BerryAudio/BGP/GERBER/XMERGE/BGP_Combined_Bottom.png

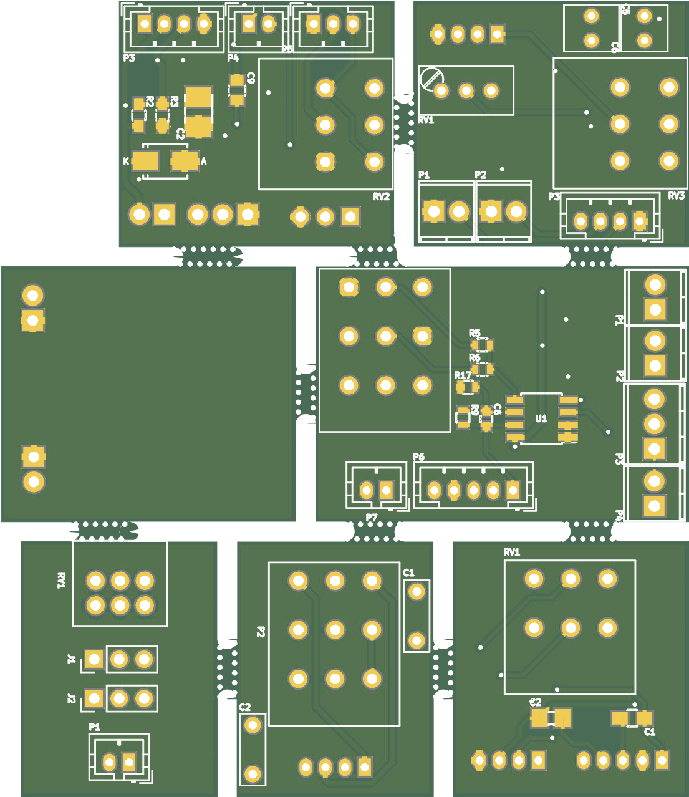
GERBER/XMERGE/BGP_Combined_Bottom.png
