BerryAudio/BGP/GERBER/XMERGE/BGP_Combined_Top.png

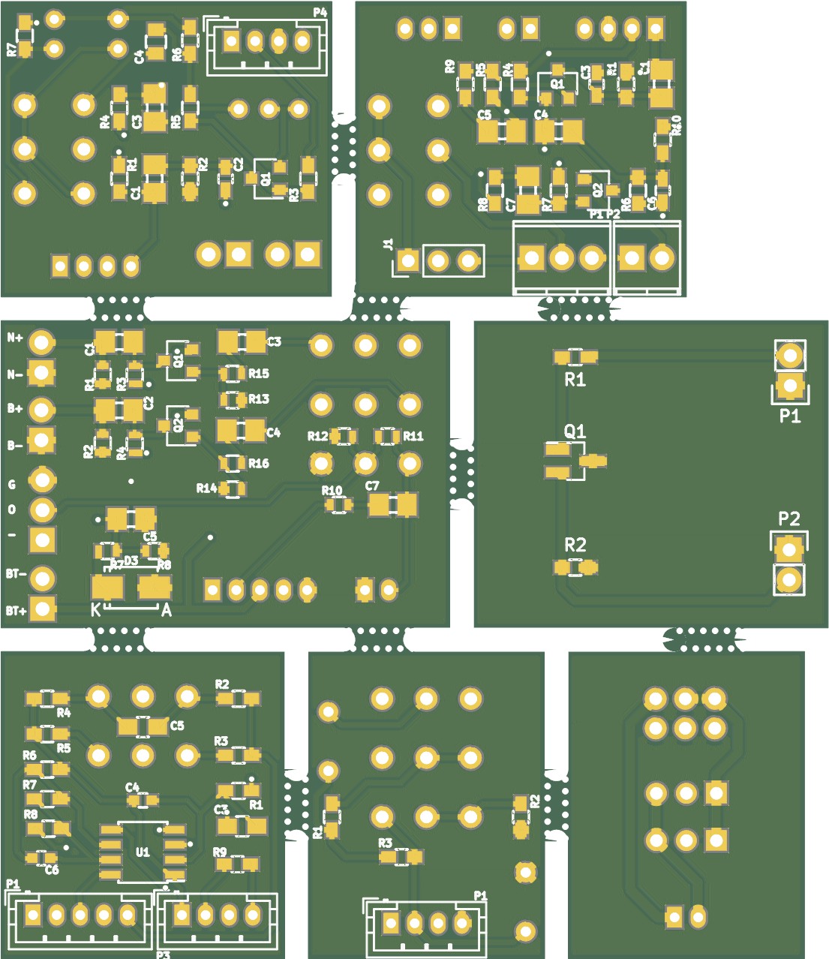
GERBER/XMERGE/BGP_Combined_Top.png
