BerryAudio/BGP/GERBER/BOM.xlsx

Sheet: J0
J0
VOL | QTY | VAL | PART NO
C | 3 | 0.1u | TAJR104K035RNJ | 35v | 0.627 | 1.881 | 11.286 | ECPU1C104MA5 | RS Australia
 | 3 | 47u | TCTAL1A476M8R | 10v | 0.657 | 1.971 | 7.884
 | 3 | 270p | CC0603JRNPO9BN271 | 50v | 0.048 | 0.144 | 0.96
 | 1 | 1u | F921A475MPA | 10v | 0.331 | 0.331 | 3.31
 | 1 | 1000p | ECH-U1H102JX5 | 50v | 0.431 | 0.431 | 4.31
D | 1 |  | S1A-13-F |  | 0.253 | 0.253 | 2.53
R | 2 | 1k | CR0603-FX-1001HLF |  | 0.019 | 0.038 | 1.9
 | 1 | 3.9k | CR0603-FX-3901ELF |  | 0.019 | 0.019 | 1.9
 | 3 | 10k | CR0603-FX-1002ELF |  | 0.019 | 0.057 | 1.9
 | 1 | 20k | CR0603-FX-2002ELF |  | 0.019 | 0.019 | 1.9
 | 1 | 100k | CR0603-FX-1003HLF |  | 0.019 | 0.019 | 1.9
 | 2 | 1MEG | CR0603-JW-105ELF |  | 0.009 | 0.018 | 0.9
 |  |  |  |  |  | 5.181 | 40.68
BT | QTY | VAL | PART NO
C | 1 | 2700p | 667-ECH-U1H272JX5 | 50v | 0.431 | 0.431 | 5.172
 | 1 | 0.1u | TAJR104K035RNJ | 35v | 0.627 | 0.627 | 7.524 | ECPU1C104MA5 | RS Australia
 | 1 | 47u | TCTAL1A476M8R | 10v | 0.657 | 0.657 | 7.884
 | 1 | 0.33u | MKS0C033300D00KSSD |  | 0.978 | 0.978 | 9.78
 | 1 | 1u | MKS02-1/50/10 |  | 1.89 | 1.89 | 18.9
R | 1 | 1.8k | CR0603-FX-1801ELF |  | 0.012 | 0.012 | 1.2
POT | 1 | 20k | 3296W-1-103LF |  | 2.55 | 2.55 | 25.5
 |  |  |  |  |  | 7.145 | 75.96
TERMINALS | QTY | VAL | PART NO
2WAY | 3 |  | 282834-2 |  | 0.616 | 1.848 | 11.088
3WAY | 1 |  | 282834-3 |  | 1.49 | 1.49 | 8.94
JACK | 1 |  | 502-12B |  | 4.69 | 4.69 | 9.38
SIL STRIP | 2 |  | D01-9972042 |  | 2.1 | 5.69 | 5.69
2PIN JUMPER | 2 |  | 571-1-881545-4 |  | 0.118 | 6.69 | 2.95
 |  |  |  |  |  | 20.408 | 38.048
 |  |  |  |  |  | 32.734 | 154.688

Sheet: F0
J0
BUF | QTY | VAL | PART NO
C | 1 | 270p | CC0603JRNPO9BN271 | 50v | 0.048 | 0.048 | 0.96
 | 2 | 0.1u | TAJR104K035RNJ | 35v | 0.627 | 1.254 | 7.524 | ECPU1C104MA5 | RS Australia
 | 2 | 1u | F921A475MPA | 10v | 0.331 | 0.662 | 3.31
 | 2 | 10u | TCTP1C106M8R | 16V | 0.663 | 1.326 | 6.63
D | 1 |  | S1A-13-F |  | 0.019 | 0.019 | 1.9
R | 3 | 1k | CR0603-FX-1001HLF |  | 0.019 | 0.057 | 1.9
 | 2 | 10k | CR0603-FX-1002ELF |  | 0.019 | 0.038 | 1.9
 | 1 | 12k | CR0603-FX-1202ELF |  | 0.019 | 0.019 | 1.9
 | 1 | 15k | CR0603-FX-1502HLF |  | 0.019 | 0.019 | 1.9
 | 2 | 20k | CR0603-FX-2002ELF |  | 0.019 | 0.038 | 1.9
 | 2 | 47k | CR0603-FX-4702ELF |  | 0.019 | 0.038 | 1.9
 | 2 | 100k | CR0603-FX-1003HLF |  | 0.019 | 0.038 | 1.9
 | 2 | 330k | CR0603-JW-334ELF |  | 0.009 | 0.018 | 0.9
 | 2 | 1Meg | CR0603-JW-105ELF |  | 0.009 | 0.018 | 0.9
Q | 1 | TS512A | TS512IDT |  | 1.27 | 1.27 | 12.7
BT | QTY | VAL | PART NO
C | 2 | 270p | CC0603JRNPO9BN271 | 50v | 0.048 | 0.096 | 0.96
 | 1 | 0.01u | ECH-U1C103JX5 | 16V | 0.45 | 0.45 | 4.5
 | 1 | 0.1u | TAJR104K035RNJ | 35v | 0.627 | 0.627 | 3.762
 | 2 | 10u | KRM21ER61E106KFA1L | 25V | 0.461 | 0.922 | 4.61
R | 1 | 1k | CR0603-FX-1001HLF |  | 0.019 | 0.019 | 1.9
 | 3 | 1.8k | CR0603-FX-1801ELF |  | 0.012 | 0.036 | 1.2
 | 2 | 6.8k | CR0603-FX-6801ELF |  | 0.012 | 0.024 | 1.2
 | 2 | 20k | CR0603-FX-2002ELF |  | 0.019 | 0.038 | 1.9
 | 1 | 100k | CR0603-FX-1003HLF |  | 0.019 | 0.019 | 1.9
Q | 1 | TS512A | TS512IDT |  | 1.27 | 1.27 | 0
MID | QTY | VAL | PART NO
C | 1 | 10n | MKS2C021001A00KI00 |  | 0.222 | 0.222 | 2.22
 | 1 | 22n | MKS2-.22/63/10 |  | 0.35 | 0.35 | 3.5
R | 2 | 4.7k | CR0603-FX-4701ELF |  | 0.019 | 0.038 | 1.9
 | 1 | 100k | CR0603-FX-1003HLF |  | 0.019 | 0.019 | 1.9
TERMINALS | QTY | VAL | PART NO
2WAY | 3 |  | 282834-2 |  | 0.616 | 1.848 | 11.088
3WAY | 1 |  | 282834-3 |  | 1.49 | 1.49 | 8.94
JACK | 1 |  | 502-12B |  | 4.69 | 4.69 | 9.38
SIL STRIP | 2 |  | D01-9972042 |  | 2.1 | 5.69 | 5.69
2PIN JUMPER | 1 |  | 571-1-881545-4 |  | 0.118 | 6.69 | 2.95

Sheet: MM
J0
SWITCHES | QTY | VAL | PART NO |  |  | $ | TOT
SW_SEL/MM | 2 |  | 100DP6T1B1M2QE |  | 4 | 5.71 | 22.84
SW_BRIGHT | 1 |  | 100SP1T1B1M2QEH |  | 2 | 2.83 | 5.66
SW_DUAL_MM | 1 |  | M2044SS1W03 |  | 1 | 21.2 | 21.2
BND
-
BT
C1 | 1 | 0.1u | TAJR104K035RNJ | 0805 | 2 | 0.627 | 1.254
C2, C13 | 2 | 1u | F921A475MPA | 0805 | 4 | 0.331 | 1.324
C3 | 1 | 10n | ECH-U1C103JX5 | 0805 | 2 | 0.791 | 1.582
C4 | 1 | 1.8n | ECH-U1H182JX5 | 0805 | 2 | 0.71 | 1.42
C5 | 1 | 10u | TCP1A106M8R | 0805 | 2 | 0.549 | 1.098
C6, C9 | 2 | 47u | TCTAL1A476M8R | 1206 | 4 | 0.657 | 2.628
C7 | 1 | 470p | VJ0603A471GXXCW1BC | 0603 | 2 | 0.134 | 0.268
C8, C12 | 2 | 120p | CC0603JRNPO9BN271 | 1206 | 4 | 0.048 | 0.192
C11 | 1 | 47n | ECH-U1C473GX5 | 1206 | 2 | 1.15 | 2.3
D | 1 |  | S1A-13-F |  | 2 | 0.253 | 0.506
Q1 | 1 |  | MMBF5457 |  | 2 |  | 0
R1 | 1 | 470k |  |  | 2 | 0.019 | 0.038
R2 | 1 | 1MEG |  |  | 2 | 0.019 | 0.038
R3, R9, R10, R12, R14 | 5 | 20k |  |  | 10 | 0.019 | 0.19
R4, R16 | 2 | 100 |  |  | 4 | 0.019 | 0.076
R5, R13 | 2 | 200k |  |  | 4 | 0.019 | 0.076
R6, R8 | 2 | 2k |  |  | 4 | 0.019 | 0.076
R7 | 1 | 100k |  |  | 2 | 0.019 | 0.038
R11 | 1 | 10k |  |  | 2 | 0.019 | 0.038
R15 | 1 | 1k |  |  | 2 | 0.019 | 0.038
U1 | 1 |  | TS512A |  | 2 | 1.27 | 2.54
RV1 | 1 | 1MEG | RV16AF-20-15S1-C1M-LA |  | 2 | 2.16 | 4.32
BASS
RV1 | 1 | 250k | RV16AF-20-15S1-A250K-LA |  | 2 | 2.16 | 4.32
2WAY | 3 |  | 282834-2 |  | 6 | 0.616 | 3.696
3WAY | 2 |  | 282834-3 |  | 4 | 1.49 | 5.96
 |  |  |  |  |  |  | 83.716

Sheet: Sheet1
C | 1 | VAL | TYPE | RATING | FOOTPRINT | PART | QTY 2 | QTY BEST | COST1 | COST10 | COST50 | TOTAL | SHEETS DONE
 | 1 | 10p | CERMAIC C0G | 25V | 0603 | VJ0603A100JXXCW1BC | 2 | 10 | 0.138 | 0.138 | 0.083 | 1.38 | F0 | BT
 | 2 | 68p | CERMAIC C0G | 25V | 0603 | VJ0603A680KXXPW1BC | 4 | 10 | 0.138 | 0.138 | 0.083 | 1.38 |  | BUF
 | 3 | 100p | CERMAIC C0G | 25V | 0603 | VJ0603A101KXXPW1BC | 6 | 10 | 0.138 | 0.138 | 0.083 | 1.38 |  | MID
 | 7 | 270p | CERMAIC C0G | 50V | 0603 | VJ0603A271JXACW1BC | 14 | 20 | 0.111 | 0.111 | 0.097 | 2.22 |  | TONE
 | 1 | 1n | FILM | 50V | 0805 | ECH-U1H102JX5 | 2 | 4 | 0.774 | 0.445 | 0.3 | 3.096 | J0 | BND
 | 4 | 2700p | FILM | 50V | 0805 | ECH-U1H272JX5 | 8 | 10 | 0.774 | 0.445 | 0.3 | 4.45 |  | BT
 | 1 | 4700p | FILM | 16V | 0805 | ECH-U1C472JX5 | 2 | 4 | 0.761 | 0.434 | 0.293 | 3.044 |  | VOL
 | 3 | 10n | FILM | 16V | 0805 | ECH-U1C103GX5 | 6 | 10 | 0.871 | 0.495 | 0.495 | 4.95 | MM | BT
 | 1 | 22n | FILM | 16V | 1206 | ECH-U1C223JX5 | 2 | 4 | 0.719 | 0.39 | 0.39 | 2.876 |  | MID
 | 1 | 22n | FILM | 40V | RADIAL | MKP2D022201B00JO00 | 2 | 4 | 0.263 | 0.234 | 0.198 | 1.052 |  | BASS
 | 6 | 0.1u | FILM | 16V | 0805 | FCA0805C104M-J2 | 12 | 15 | 0.94 | 0.697 | 0.697 | 10.455 |  | VOL
 | 1 | 0.22u | FILM | 40V | RADIAL | MKS2D032201C00KI00 | 2 | 2 | 0.304 | 0.297 | 0.297 | 0.608 |  | SW_BR
 | 1 | 0.47u | FILM | 40V | RADIAL | MKS0C033300D00KSSD | 2 | 2 | 1.01 | 0.934 | 0.857 | 2.02 |  | SW_MM
 | 1 | 1u | FILM | 40V | RADIAL | MKS02-1/50/10 | 2 | 2 | 2.24 | 1.88 | 1.49 | 4.48 |  | SW_SEL
 | 3 | 1u | TANTALUM | 20V | 0805 | TAJR105K020YNJ | 6 | 10 | 0.36 | 0.261 | 0.261 | 2.61
 | 6 | 10u | TANTALUM | 16V | 0805 | TCTP1C106M8R | 12 | 15 | 0.83 | 0.685 | 0.685 | 10.275
 | 5 | 10u | CERAMIC X5R | 25V | 1206 | TMK316ABJ106KD-T | 10 | 15 | 0.567 | 0.271 | 0.271 | 4.065
 | 3 | 47u | TANTALUM | 10V | 1206 | F931A476KAA | 6 | 10 | 0.816 | 0.678 | 0.437 | 6.78
D | 2 | 2 | S1A |  | SMA | 512-S1A | 4 | 0 | 0.416 | 0.281 | 0.118 | 0
TERM BLOCK
 | 11 | x2 |  |  |  | 282834-2 | 22 | 22 | 0.719 | 0.636 | 0.62 | 13.992
 | 3 | x3 |  |  |  | 282834-3 | 6 | 6 | 1.54 | 1.41 | 1.3 | 9.24
U | 1 |  | TL061 |  | SOIC | TL061CDT | 2 | 4 | 0.609 | 0.501 | 0.306 | 2.436
POT | 1 | A25k | 16mm |  |  | RV16AF-20-15S1-A25K-LA | 2 | 2 | 2.23 | 1.91 | 1.7 | 4.46
 | 1 | A100k | 16mm |  |  | RV16AF-20-15S1-A100K-LA | 2 | 2 | 2.23 | 1.91 | 1.7 | 4.46
 | 1 | A250k | 16mm |  |  | RV16AF-20-15S1-A250K-LA | 2 | 2 | 2.23 | 1.91 | 1.7 | 4.46
 | 1 | C1M | 16mm |  |  | RV16AF-20-15S1-C1M-LA | 2 | 2 | 2.23 | 1.91 | 1.7 | 4.46
 | 1 | 20k | TRIM |  |  | 3296W-1-203LF | 2 | 2 | 3.33 | 2.63 | 2.32 | 6.66
R | 2 | 100 |  |  | 0603 | CR0603-JW-101ELF | 4 | 20 | 0.138 | 0.022 | 0.01 | 0.44
 | 7 | 1k |  |  | 0603 | CR0603-JW-102ELF | 14 | 40 | 0.138 | 0.022 | 0.01 | 0.88
 | 4 | 1.8k |  |  | 0603 | CR0603-JW-182ELF | 8 | 20 | 0.138 | 0.022 | 0.01 | 0.44
 | 2 | 3.9k |  |  | 0603 | CR0603-JW-392ELF | 4 | 20 | 0.138 | 0.022 | 0.01 | 0.44
 | 1 | 4.7k |  |  | 0603 | CR0603-JW-472ELF | 2 | 20 | 0.138 | 0.022 | 0.01 | 0.44
 | 2 | 6.8k |  |  | 0603 | CR0603-FX-6801ELF | 4 | 20 | 0.138 | 0.077 | 0.032 | 1.54
 | 12 | 10k |  |  | 0603 | CR0603-FX-1002GLF | 24 | 40 | 0.138 | 0.029 | 0.012 | 1.16
 | 1 | 15k |  |  | 0603 | CR0603-FX-1502ELF | 2 | 20 | 0.138 | 0.014 | 0.008 | 0.28
 | 8 | 20k |  |  | 0603 | CR0603-FX-2002HLF | 16 | 40 | 0.138 | 0.039 | 0.021 | 1.56
 | 11 | 100k |  |  | 0603 | CR0603-FX-1003HLF | 22 | 40 | 0.138 | 0.035 | 0.019 | 1.4
W | 4 | 200k |  |  | 0603 | CR0603-FX-2003ELF | 8 | 20 | 0.138 | 0.032 | 0.014 | 0.64
 | 3 | 470k |  |  | 0603 | CR0603-FX-4703ELF | 6 | 20 | 0.138 | 0.029 | 0.012 | 0.58
 | 6 | 1MEG |  |  | 0603 | CR0603-JW-105GLF | 12 | 40 | 0.138 | 0.048 | 0.021 | 1.92
SW | 2 | DPDT | ON ON ON |  |  | 100DP6T1B1M2QE | 4 | 4 | 5.89 | 5.64 | 4.66 | 23.56
 |  |  |  |  |  |  |  |  |  |  |  | 152.569
NP MOUSER
POT | 1 |  | ALPHA CONCENTRIC | A100k |  |  | 2
 | 1 |  |  | B50k |  |  | 2
 | 2 |  |  | B20k, 2xC100k |  |  | 4
 | 1 |  |  | A25k |  |  | 2
 | 1 |  |  | A250k |  |  | 2
 | 1 |  | BOURNES 2G P/P | A500k |  | PDB183-GTR22-504A2 | 2
U | 3 |  | TS512A |  |  |  | 6
Q | 6 |  | MMBF5457 |  |  |  | 12
CNN | 4 | K | JST | x2 |  |  | 8
 | 4 | K | JST | x4 |  |  | 8
SW | 1 |  | M2044SS1W03 |  |  |  | 2
PINS | 20 | x5 | Male Long/short
 | 1 | x3 | Female Short/Short
