BerryAudio/BGP/BOM.xlsx

Sheet: Sheet1
J0_BT
C | C1 | 0.1u | TANT | 0805 | TAJR104M020RNJ | 0.796 | 0.601
 | C2 | 27p | CERAMIC | 0603 | ECH-U1C101JX5 | 0.686
 | C3 | 47u | TANT | 0805 | T58W9476M6R3C0150 | 0.713
 | C4 | 2.7n | FILM | 0603 | ECH-U1H272GX5 | 0.796 | 0.457
 | C5 | 1u | FILM | 2.5mm | 505-MKS02-1/50/10 | 1.93
 | C6 | 470n | FILM | 2.5mm | 505-MKS02.47/63/10 | 2.22
P | P1 |  |  | 2.54mm | 282834-2 | 0.713 | 0.631
 | P2 |  |  | 2.54mm | 282834-2 | 0.713 | 0.631
Q | Q1 |  |  | SOT23 | MMBFJ202 | 0.494 | 0.199
R | R1 | 1.5MEG |  | 0603 | CR0603-FX-1504ELF | 0.165 | 0.04
 | R2 | 1MEG |  | 0603 | CR0603-FX-1004ELF | 0.137 | 0.034
 | R3 | 6.8k |  | 0603 | CR0603-FX-6801ELF | 0.137 | 0.077
 | R4 | 3.9k |  | 0603 | CR0603-FX-3901ELF | 0.137 | 0.034
 | R5 | 100 |  | 0603 | CR0603-FX-1000ELF | 0.137 | 0.049
 | R6 | 10k |  | 0603 | CR0603-FX-1002ELF | 0.137 | 0.029
 | R7 | 1.8k |  | 0603 | CR0603-FX-1801ELF | 0.137 | 0.029
RV | RV1 | 20k |  | 3296W | 3296W-1-203LF | 3.31 | 2.61
J0_VOL
C | C1 | 0.1u | TANT | 0805 | TAJR104M020RNJ | 0.796 | 0.601
 | C2 | 100u | CERAMIC | 0805 | 12106D107MAT2A | 0.947
 | C3 | 270p | FILM | 0603 | ECH-U1C271JXG | 0.439 | 0.214
 | C4 | 0.1u | TANT | 0805 | TAJR104M020RNJ | 0.796 | 0.601
 | C5 | 47u | TANT | 0805 | T58W9476M6R3C0150 | 0.713
 | C6 | 270p | FILM | 0603 | ECH-U1C271JXG | 0.439 | 0.214
 | C7 | 10u | TANT | 0805 | F920G106MPA | 0.508 | 0.446
 | C8 | 0.047u | FILM | MKP2 | MKS2D024701A00JI00 | 0.563 | 0.501
 | C8* | 0.1u | FILM | MKP2 | MKS2D031001A00KA00 | 0.206 | 0.199
 | C9 | 1n | FILM | 0805 | ECH-U1H102JX5 | 0.768 | 0.442
D | D1 | S1A-13-F |  | SMA | S1A-13-F | 0.384 | 0.259
P | P1 |  |  | 2.54mm | 282834-3 | 1.52 | 1.4
 | P2 |  |  | 2.54mm | 282834-2 | 0.713 | 0.631
Q | Q1 |  |  | SOT23 | MMBFJ202 | 0.494 | 0.199
 | Q2 |  |  | SOT23 | MMBFJ202 | 0.494 | 0.199
R | R1 | 1MEG |  | 0603 | CR0603-FX-1004ELF | 0.137 | 0.034
 | R2 | 100k |  | 0603 | CR0603-FX-1003ELF | 0.165 | 0.04
 | R3 | 10k |  | 0603 | CR0603-FX-1002ELF | 0.137 | 0.029
 | R4 | 10k |  | 0603 | CR0603-FX-1002ELF | 0.137 | 0.029
 | R5 | 4.7k |  | 0603 | CR0603-FX-4701ELF | 0.137 | 0.012
 | R6 | 1MEG |  | 0603 | CR0603-FX-1004ELF | 0.137 | 0.034
 | R7 | 20k |  | 0603 | CR0603-FX-2002ELF | 0.137 | 0.029
 | R8 | 100 |  | 0603 | CR0603-FX-1000ELF | 0.137 | 0.049
 | R9 | 1.8k |  | 0603 | CR0603-FX-1801ELF | 0.137 | 0.029
 | R10 | 1.5MEG |  | 0603 | CR0603-FX-1504ELF | 0.165 | 0.04
J0_BLEND | RV1 |  |  |  | PDB183-GTR22-504A2 | 8.63
F0_BT
C | C1 | 10u | TANT | 0805 | F920G106MPA | 0.508 | 0.446
 | C2 | 10u | TANT | 0805 | F920G106MPA | 0.508 | 0.446
 | C3 | 10n | FILM | 0805 | ECH-U1C103GX5 | 0.864 | 0.491
 | C4 | 270p | FILM | 0603 | ECH-U1C271JXG | 0.439 | 0.214
 | C5 | 0.1u | FILM | 0805 | ECP-U1C104MA5 | 1.15 | 0.66
 | C6 | 270p | FILM | 0603 | ECH-U1C271JXG | 0.439 | 0.214
R | R1 | 1.8k |  | 0603 | CR0603-FX-1801ELF | 0.137 | 0.029
 | R2 | 4.7k |  | 0603 | CR0603-FX-4701ELF | 0.137 | 0.012
 | R3 | 10k |  | 0603 | CR0603-FX-1002ELF | 0.137 | 0.029
 | R4 | 4.7k |  | 0603 | CR0603-FX-4701ELF | 0.137 | 0.012
 | R5 | 1k |  | 0603 | CR0603-FX-1001ELF | 0.137 | 0.029
 | R6 | 20k |  | 0603 | CR0603-FX-2002ELF | 0.137 | 0.029
 | R7 | 20k |  | 0603 | CR0603-FX-2002ELF | 0.137 | 0.029
 | R8 | 100 |  | 0603 | CR0603-FX-1000ELF | 0.137 | 0.049
U | U1 | TS512IDT |  |  | TS512IDT | 1.51 | 1.31
F0_BUF
C | C1 | 0.1u | FILM | 0805 | ECP-U1C104MA5 | 1.15 | 0.66
 | C2 | 0.1u | FILM | 0805 | ECP-U1C104MA5 | 1.15 | 0.66
 | C3 | 1u | TANT | 0805 | TPSR105K020R6000 | 0.37
 | C4 | 1u | TANT | 0805 | TPSR105K020R6000
 | C5 | 10u | TANT | 0805 | F920G106MPA | 0.508 | 0.446
 | C6 | 270p | FILM | 0603 | ECH-U1C271JXG | 0.439 | 0.214
D | D1 | S1A-13-F |  | SMA | S1A-13-F | 0.384 | 0.259
P | P1 |  |  | 2.54mm | 282834-3 | 1.52 | 1.4
 | P2 |  |  | 2.54mm | 282834-2 | 0.713 | 0.631
 | P2 |  |  | 2.54mm | 282834-2 | 0.713 | 0.631
 | P2 |  |  | 2.54mm | 282834-2 | 0.713 | 0.631
Q | Q1 |  |  | SOT23 | MMBF5457 | 0.494 | 0.199
 | Q2 |  |  | SOT23 | MMBF5457 | 0.494 | 0.199
R | R1 | 330k |  | 0603 | CR0603-FX-3303ELF | 0.137 | 0.034
 | R2 | 330k |  | 0603 | CR0603-FX-3303ELF | 0.137 | 0.034
 | R3 | 1MEG |  | 0603 | CR0603-FX-1004ELF | 0.137 | 0.034
 | R4 | 1MEG |  | 0603 | CR0603-FX-1004ELF | 0.137 | 0.034
 | R5 | 47k |  | 0603 | CR0603-FX-4701ELF | 0.137 | 0.036
 | R6 | 47k |  | 0603 | CR0603-FX-4701ELF | 0.137 | 0.036
 | R7 | 100k |  | 0603 | CR0602-FX-1003ELF | 0.137 | 0.034
 | R8 | 100k |  | 0603 | CR0602-FX-1003ELF | 0.137 | 0.034
 | R9 | 15k |  | 0603 | CR0603-FX-1502ELF | 0.137 | 0.049
 | R10 | 100 |  | 0603 | CR0603-FX-1000ELF | 0.137 | 0.049
 | R11 | 10k |  | 0603 | CR0603-FX-1002ELF | 0.137 | 0.029
 | R12 | 12k |  | 0603 | CR0603-FX-1202ELF | 0.137 | 0.029
 | R13 | 20k |  | 0603 | CR0603-FX-2002ELF | 0.137 | 0.029
 | R14 | 20k |  | 0603 | CR0603-FX-2002ELF | 0.137 | 0.029
 | R15 | 1k |  | 0603 | CR0603-FX-1001ELF | 0.137 | 0.029
 | R16 | 1k |  | 0603 | CR0603-FX-1001ELF | 0.137 | 0.029
 | R17 | 10k |  | 0603 | CR0603-FX-1002ELF | 0.137 | 0.029
U | U1 | TS512IDT |  |  | TS512IDT | 1.51 | 1.31
F0_MID
C | C1 | 22n | FILM | 5mm | MKS2D022201A00KO00 | 0.864 | 0.491
 | C2 | 10n | FILM | 5mm | MKS2C021001A00MI00 | 0.823 | 0.472
R | R1 | 4.7k |  | 0603 | CR0603-FX-4701ELF | 0.137 | 0.012
 | R2 | 4.7k |  | 0603 | CR0603-FX-4701ELF | 0.137 | 0.012
 | R3 | 100k |  | 0603 | CR0602-FX-1003ELF | 0.137 | 0.034
TONE CAPS | C1 | 47n |  | 5mm | 505-MKS2D024701AJI00 |  | 0.501
 | C2 | 470n |  | 5mm | MKS2C034701C00JO00 | 0.335
TERM BLK |  |  |  |  | 571-282834-2 | 0.631
 |  |  |  |  | 571-2828343 | 1.52

Sheet: Sheet2
 | C8 | 0.047u | FILM | MKP2 | MKS2D024701A00JI00 | 0.563 | 0.501
C | C1 | 0.1u | TANT | 0805 | TAJR104M020RNJ | 0.796 | 0.601
C | C1 | 0.1u | TANT | 0805 | TAJR104M020RNJ | 0.796 | 0.601
 | C4 | 0.1u | TANT | 0805 | TAJR104M020RNJ | 0.796 | 0.601
 | C8* | 0.1u | FILM | MKP2 | MKS2D031001A00KA00 | 0.206 | 0.199
 | C5 | 0.1u | FILM | 0805 | ECP-U1C104MA5 | 1.15 | 0.66
C | C1 | 0.1u | FILM | 0805 | ECP-U1C104MA5 | 1.15 | 0.66
 | C2 | 0.1u | FILM | 0805 | ECP-U1C104MA5 | 1.15 | 0.66
 | C2 | 100u | CERAMIC | 0805 | 12106D107MAT2A | 0.947
 | C3 | 10n | FILM | 0805 | ECH-U1C103GX5 | 0.864 | 0.491
 | C2 | 10n | FILM | 5mm | MKS2C021001A00MI00 | 0.823 | 0.472
 | C7 | 10u | TANT | 0805 | F920G106MPA | 0.508 | 0.446
C | C1 | 10u | TANT | 0805 | F920G106MPA | 0.508 | 0.446
 | C2 | 10u | TANT | 0805 | F920G106MPA | 0.508 | 0.446
 | C5 | 10u | TANT | 0805 | F920G106MPA | 0.508 | 0.446
 | C9 | 1n | FILM | 0805 | ECH-U1H102JX5 | 0.768 | 0.442
 | C5 | 1u | FILM | 2.5mm | 505-MKS02-1/50/10 | 1.93
 | C3 | 1u | TANT | 0805 | TPSR105K020R6000 | 0.37
 | C4 | 1u | TANT | 0805 | TPSR105K020R6000
 | C4 | 2.7n | FILM | 0603 | ECH-U1H272GX5 | 0.796 | 0.457
C | C1 | 22n | FILM | 5mm | MKS2D022201A00KO00 | 0.864 | 0.491
 | C3 | 270p | FILM | 0603 | ECH-U1C271JXG | 0.439 | 0.214
 | C6 | 270p | FILM | 0603 | ECH-U1C271JXG | 0.439 | 0.214
 | C4 | 270p | FILM | 0603 | ECH-U1C271JXG | 0.439 | 0.214
 | C6 | 270p | FILM | 0603 | ECH-U1C271JXG | 0.439 | 0.214
 | C6 | 270p | FILM | 0603 | ECH-U1C271JXG | 0.439 | 0.214
 | C2 | 27p | CERAMIC | 0603 | ECH-U1C101JX5 | 0.686
 | C6 | 470n | FILM | 2.5mm | 505-MKS02.47/63/10 | 2.22
 | C2 | 470n |  | 5mm | MKS2C034701C00JO00 | 0.335
TONE CAPS | C1 | 47n |  | 5mm | 505-MKS2D024701AJI00 |  | 0.501
 | C3 | 47u | TANT | 0805 | T58W9476M6R3C0150 | 0.713
 | C5 | 47u | TANT | 0805 | T58W9476M6R3C0150 | 0.713
TERM BLK |  |  |  |  | 571-282834-2 | 0.631
 |  |  |  |  | 571-2828343 | 1.52
Q |  | MMBFJ202 |  |  |  | 0.51 | 0.203
U | U1 | TS512IDT |  |  | TS512IDT | 1.51 | 1.31
 | R10 | 100 |  | 0603 | CR0603-FX-1000ELF | 0.137 | 0.049
 | R8 | 100 |  | 0603 | CR0603-FX-1000ELF | 0.137 | 0.049
 | R5 | 100 |  | 0603 | CR0603-FX-1000ELF | 0.137 | 0.049
 | R10 | 1.5MEG |  | 0603 | CR0603-FX-1504ELF | 0.165 | 0.04
R | R1 | 1.5MEG |  | 0603 | CR0603-FX-1504ELF | 0.165 | 0.04
R | R1 | 1.8k |  | 0603 | CR0603-FX-1801ELF | 0.137 | 0.029
 | R9 | 1.8k |  | 0603 | CR0603-FX-1801ELF | 0.137 | 0.029
 | R7 | 1.8k |  | 0603 | CR0603-FX-1801ELF | 0.137 | 0.029
 | R3 | 100k |  | 0603 | CR0602-FX-1003ELF | 0.137 | 0.034
 | R7 | 100k |  | 0603 | CR0602-FX-1003ELF | 0.137 | 0.034
 | R8 | 100k |  | 0603 | CR0602-FX-1003ELF | 0.137 | 0.034
 | R2 | 100k |  | 0603 | CR0603-FX-1003ELF | 0.165 | 0.04
 | R11 | 10k |  | 0603 | CR0603-FX-1002ELF | 0.137 | 0.029
 | R17 | 10k |  | 0603 | CR0603-FX-1002ELF | 0.137 | 0.029
 | R3 | 10k |  | 0603 | CR0603-FX-1002ELF | 0.137 | 0.029
 | R3 | 10k |  | 0603 | CR0603-FX-1002ELF | 0.137 | 0.029
 | R4 | 10k |  | 0603 | CR0603-FX-1002ELF | 0.137 | 0.029
 | R6 | 10k |  | 0603 | CR0603-FX-1002ELF | 0.137 | 0.029
 | R12 | 12k |  | 0603 | CR0603-FX-1202ELF | 0.137 | 0.029
 | R9 | 15k |  | 0603 | CR0603-FX-1502ELF | 0.137 | 0.049
 | R15 | 1k |  | 0603 | CR0603-FX-1001ELF | 0.137 | 0.029
 | R16 | 1k |  | 0603 | CR0603-FX-1001ELF | 0.137 | 0.029
 | R5 | 1k |  | 0603 | CR0603-FX-1001ELF | 0.137 | 0.029
 | R3 | 1MEG |  | 0603 | CR0603-FX-1004ELF | 0.137 | 0.034
 | R4 | 1MEG |  | 0603 | CR0603-FX-1004ELF | 0.137 | 0.034
R | R1 | 1MEG |  | 0603 | CR0603-FX-1004ELF | 0.137 | 0.034
 | R6 | 1MEG |  | 0603 | CR0603-FX-1004ELF | 0.137 | 0.034
 | R2 | 1MEG |  | 0603 | CR0603-FX-1004ELF | 0.137 | 0.034
 | R13 | 20k |  | 0603 | CR0603-FX-2002ELF | 0.137 | 0.029
 | R14 | 20k |  | 0603 | CR0603-FX-2002ELF | 0.137 | 0.029
 | R6 | 20k |  | 0603 | CR0603-FX-2002ELF | 0.137 | 0.029
 | R7 | 20k |  | 0603 | CR0603-FX-2002ELF | 0.137 | 0.029
 | R7 | 20k |  | 0603 | CR0603-FX-2002ELF | 0.137 | 0.029
 | R4 | 3.9k |  | 0603 | CR0603-FX-3901ELF | 0.137 | 0.034
R | R1 | 330k |  | 0603 | CR0603-FX-3303ELF | 0.137 | 0.034
 | R2 | 330k |  | 0603 | CR0603-FX-3303ELF | 0.137 | 0.034
R | R1 | 4.7k |  | 0603 | CR0603-FX-4701ELF | 0.137 | 0.012
 | R2 | 4.7k |  | 0603 | CR0603-FX-4701ELF | 0.137 | 0.012
 | R2 | 4.7k |  | 0603 | CR0603-FX-4701ELF | 0.137 | 0.012
 | R4 | 4.7k |  | 0603 | CR0603-FX-4701ELF | 0.137 | 0.012
 | R5 | 4.7k |  | 0603 | CR0603-FX-4701ELF | 0.137 | 0.012
 | R5 | 47k |  | 0603 | CR0603-FX-4701ELF | 0.137 | 0.036
 | R6 | 47k |  | 0603 | CR0603-FX-4701ELF | 0.137 | 0.036
 | R3 | 6.8k |  | 0603 | CR0603-FX-6801ELF | 0.137 | 0.077
RV | RV1 | 20k |  | 3296W | 3296W-1-203LF | 3.31 | 2.61
J0_BLEND | RV1 |  |  |  | PDB183-GTR22-504A2 | 8.63
RVTONE |  |  |  |  | RK09712200MT | 3.97

Sheet: Sheet3
PRJ | BOARD | POT | KNOB
J0 | VOL/TONE | 250kA/250kA | CONCENTRIC
 | BASS/TREBLE | 25kA/25kA | CONCENTRIC
 | BALANCE | MOUSER | SINGLE
F0 | VOL/BAL | 20kB/100kA | CONCENTRIC
 | BASS/TREBLE | 50kB/50kB | CONCENTRIC
 | MID | 20kB/100kA | CONCENTRIC
 | TONE | 20kA | SINGLE
 | Pot | Qty | Stock | Knob |  |  | SAD | NORM | STOCK | ORDER | LESS PHIL
 | 20kB/100kA | 4 | 2 | CONCENTRIC | 10 | 2 | 2 | 8 | 2 | 6 | 3
 | 50kB/50kB | 2 | 2 | SINGLE | 4 | 2 | 1 | 3 | 2 | 1 | 0
 | 250kA/250kA | 2 | 0
 | 25kA/25kA | 2 | 0
 | 20kA | 2 | 0
