BerryAudio/BGP/BGP_F1/BOM.xlsx

Sheet: Sheet1
BUF
R | R1 | 499k |  |  |  |  |  | 0603
 | R2 | 2.49k |  |  |  |  |  | 0603
 | R3 | 499k |  |  |  |  |  | 0603
 | R4 | 4.99k |  |  |  |  |  | 0603
 | R5 | 4.99k |  |  |  |  |  | 0603
 | R6 | 15k |  |  |  |  |  | 0603
 | R7 | 15k |  |  |  |  |  | 0603
 | R8 | 20k |  |  |  |  |  | 0603
 | R9 | 20k |  |  |  |  |  | 0603
 | R10 | 15k |  |  |  |  |  | 0603
 | R11 | 15k |  |  |  |  |  | 0603
POT | RV1 | 3296X |  | Bourns | 3296X-1-103LF | 3.31
C | C1 | 0.1u | TANTALUM | Vishay | TMCP1D104MTRF | 0.851 |  | 0805
 | C2 | 0.01u | FILM | Kemet | LDBCA1330GC5N0 | 1.34 | 0.849 | 1206
 | C3 | 0.01u | FILM | Kemet | LDBCA1330GC5N0 | 1.34 | 0.849 | 1206
 | C4 | 10u | TANTALUM | ROHM | TCTP1C106M8R | 0.823 | 0.679 | 0805
 | C5 | 10u | TANTALUM | ROHM | TCTP1C106M8R | 0.823 | 0.679 | 0805
IC | U1 | MC33178 | MSSOP | ON Semi |  | 1.13 | 0.955
HPF
R | R1 | 4.99k |  |  |  |  |  | 0805
 | R2 | 2.49k |  |  |  |  |  | 0805
 | R3 | 499k |  |  |  |  |  | 0805
 | R4 | 4.99k |  |  |  |  |  | 0805
 | R5 | 4.99k |  |  |  |  |  | 0805
 | R6 | 15k |  |  |  |  |  | 0805
 | R7 | 15k |  |  |  |  |  | 0805
C | C1 | 2.7n | FILM | CORNELL-Dubilier | FCP0805H272J-J1 | 0.755 | 0.546 | 0805
 | C2 | 100p | CERAMIC | AVX | 0805YA101JAT2A | 0.37 | 0.248 | 0805
 | C3 | 39n | FILM | Panasonic | ECH-U1C393GX5 | 1.18 | 0.671 | 1206
 | C4 | 10u | TANTALUM | ROHM | TCTP1C106M8R | 0.823 | 0.679 | 0805
 | C5 | 22u | TANTALUM | Vishay | TMCMA1C226MTRF | 0.37 |  | 1206
IC | U1 | MC33178 | MSSOP | ON Semi |  | 1.13 | 0.955
VOL
R | R1 | 249k |  |  |  |  |  | 0805
 | R2 | 249k |  |  |  |  |  | 0805
 | R3 | 4.99k |  |  |  |  |  | 0805
 | R4 | 4.99k |  |  |  |  |  | 0805
 | R5 | 4.99k |  |  |  |  |  | 0805
 | R6 | 4.99k |  |  |  |  |  | 0805
 | R7 | 4.99k |  |  |  |  |  | 0805
 | R8 | 4.99k |  |  |  |  |  | 0805
 | R9 | 100 |  |  |  |  |  | 0805
 | R10 | 10k |  |  |  |  |  | 0805
 | R11 | 12k |  |  |  |  |  | 0805
 | R12 | 100k |  |  |  |  |  | 0805
 | R13 | 100k |  |  |  |  |  | 0805
C | C1 | 1n | FILM | Panasonic | ECH-U1H102GX5 | 0.796 | 0.451 | 0805
 | C2 | 22u | TANTALUM | Vishay | TMCMA1C226MTRF | 0.37 |  | 1206
 | C3 | 22u | TANTALUM | Vishay | TMCMA1C226MTRF | 0.37 |  | 1206
D | D1 |  |  | Vishay | RGF1B-E3/67A | 0.659 | 0.497
IC | U1 | MC33178 | MSSOP | ON Semi |  | 1.13 | 0.955
 | U2 | MC33178 | MSSOP | ON Semi |  | 1.13 | 0.955

Sheet: Sheet2
3.978873577e-10
16931.37692
