BerryAudio/BGP/Datasheets/bartolini-switch-wiring-dual-coil.pdf

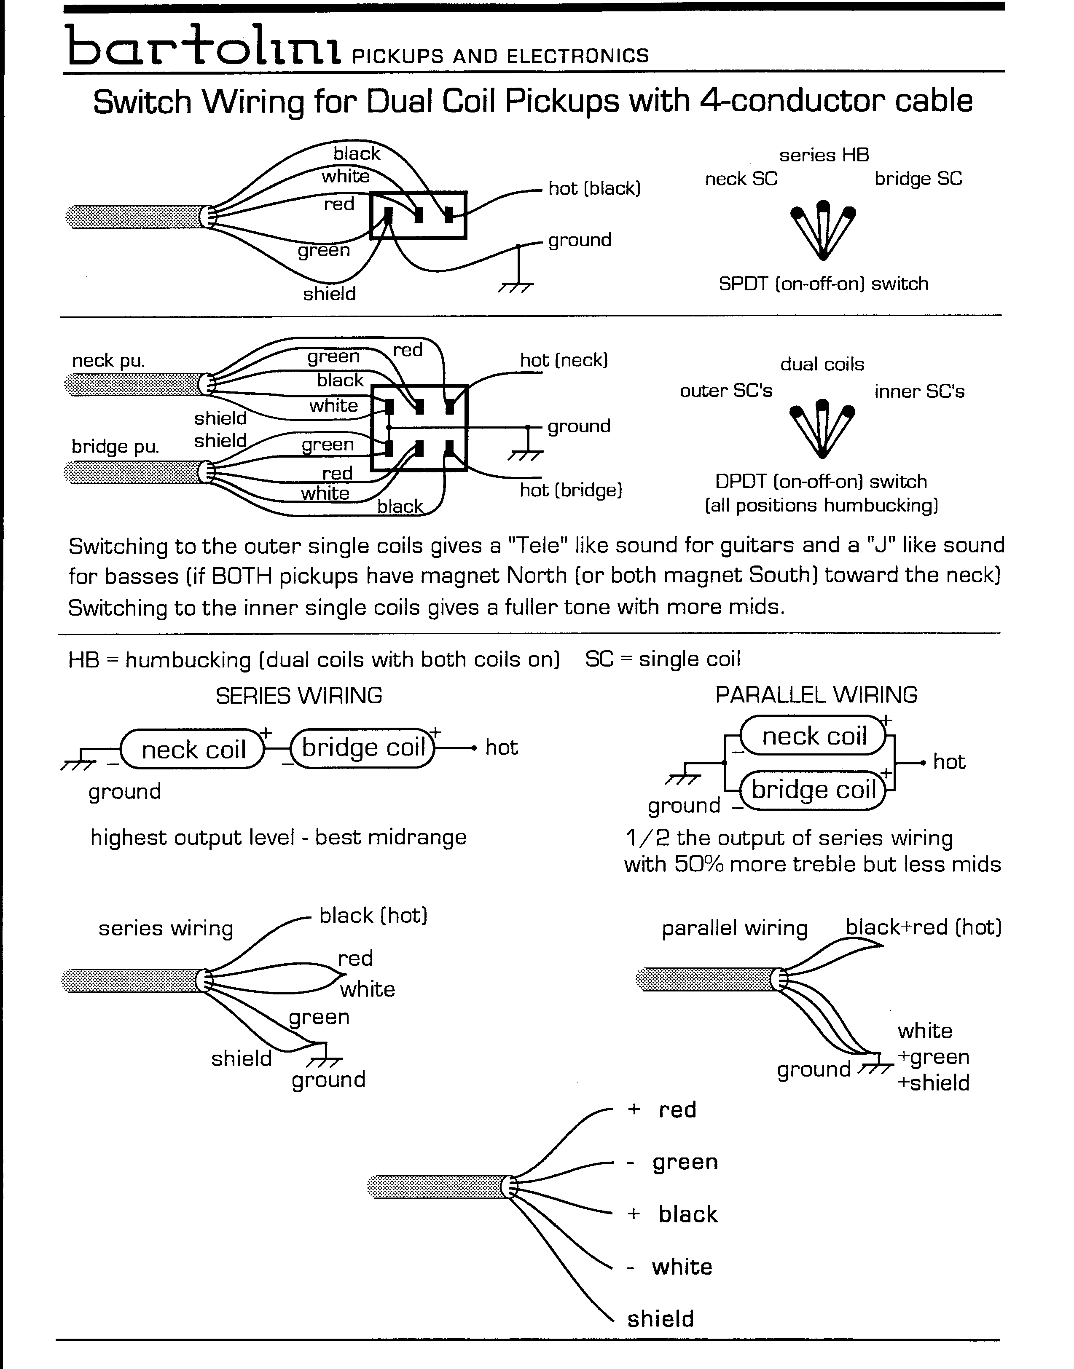
[picture p3: page 1]
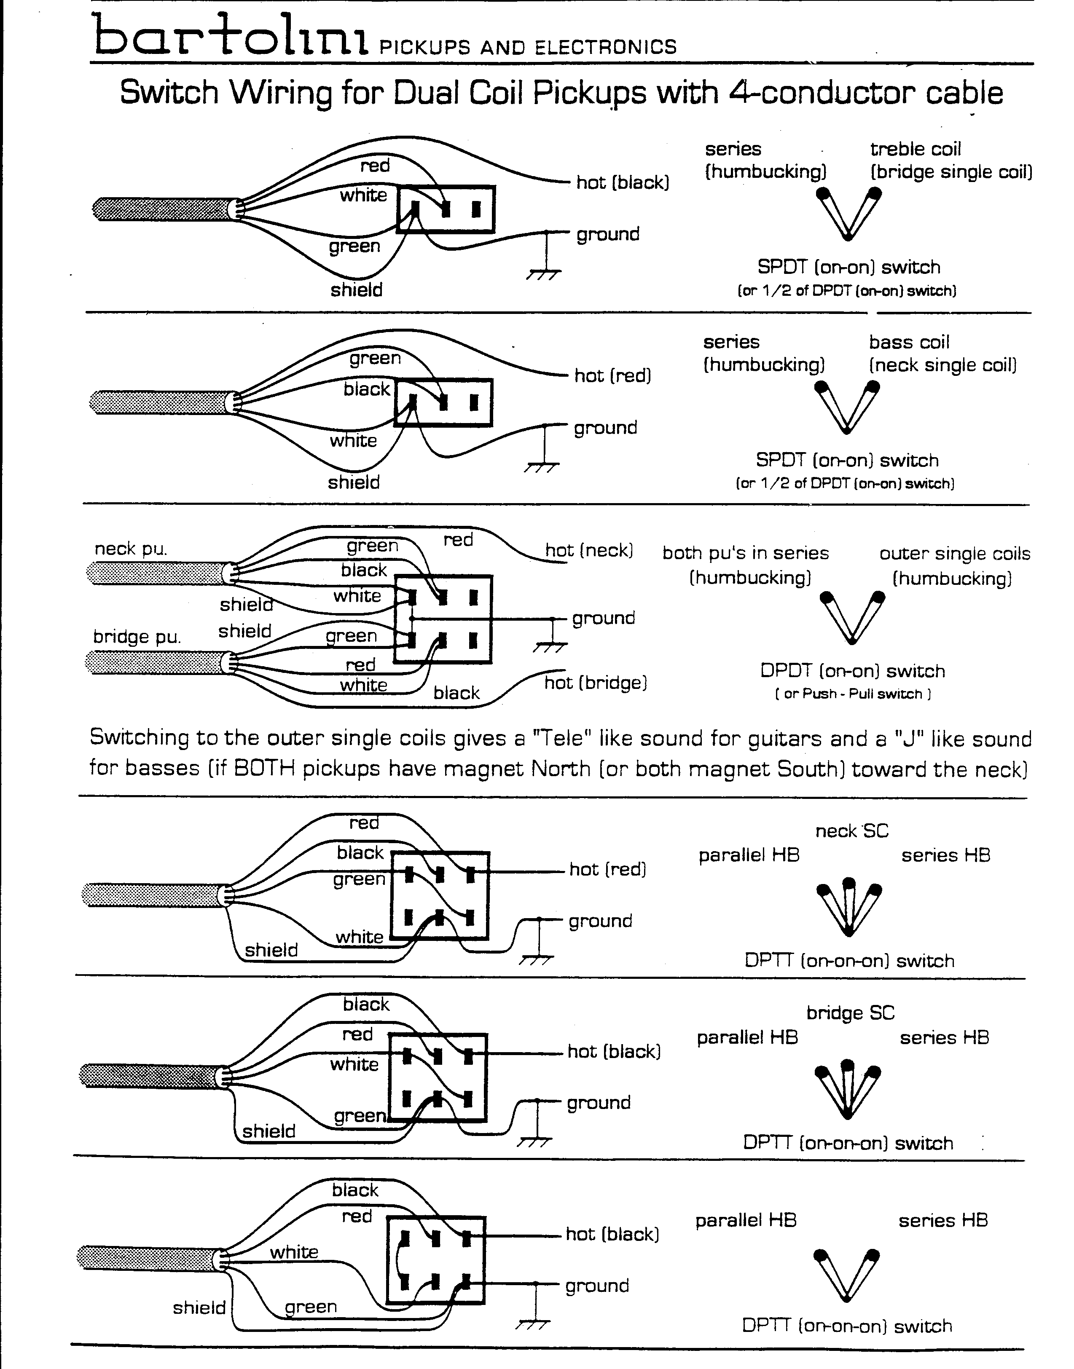
[picture p4: page 2]
