BerryAudio/BGP/BGP_MM/FINAL/CB_BGP_V0.asc

C1: cap; 10µ
C2: cap; 2.7n
C3: cap; 10p
C4: cap; 0.1µ
C5: cap; 10µ
C6: cap; 10µ
C7: cap; 10n
C8: cap; 4.7n
C9: cap; 1.8n
C10: cap; 470p
C11: cap; 100p
C12: cap; 10µ
C13: cap; 47n
C14: cap; 1µ
C15: cap; 0.1µ
C17: cap; 10µ
C18: cap; 100p
C20: cap; 2.7n
C21: cap; 100p
C22: cap; 68p
C23: cap; 2.7n
C26: cap; 10µ
C27: cap; 10p
C28: cap; 10µ
C29: cap; 47n
R1: res; 470k
R2: res; 470k
R3: res; 100
R4: res; 100k
R5: res; 220k
R6: res; {R2*10}
R7: res; {R1*10}
R8: res; 100k
R9: res; 47k
R10: res; 47k
R11: res; {R2*2.5}
R12: res; 10k
R13: res; 200k
R14: res; {R2*10}
R15: res; 4.7k
R16: res; 10k
R17: res; {R1*10}
R20: res; 200k
R21: res; 4.7k
R22: res; 10k
R25: res; 470k
R26: res; 200k
R27: res; 20k
R28: res; 20k
R29: res; 100
R30: res; 100k
R31: res; 20k
R32: res; 1
R33: res; {R2*2.5}
R34: res; 10k
R35: res; 1K
R36: res; 500k
R39: res; 10k
R40: res; {R2}
R41: res; {R2}
R42: res; 10k
U1: LT1352
U2: LT1352
U3: LT1352
U4: LT1352
U5: LT1352
V1: voltage; 9
V2: voltage; SINE(0 0.5 1k); AC 1; Rser=2k
V3: voltage; SINE(0 0.5 1k); AC 1; Rser=2k
Named nets: 0, V+, Vn, Mr, Mi, Mo, Vr, IN, Vn1, Vn2
.inc ./jfet.lib
;tran 0 100m 0 1u
.ac dec 100 1 100k
.step param Rx list 1 2 3 4 5 6 7 8 9 10 11
.param R2 table(Rx, 1, 1, 2, 200, 3, 400, 4, 800, 5, 1.5k, 6, 3k, 7, 6k, 8, 12k, 9, 25k, 10, 50k, 11, 100k)
.param R1 table(Rx, 1, 100k, 2, 99.8k, 3, 99.6k, 4, 99.2k, 5, 98.5k, 6, 97k, 7, 94k, 8, 88k, 9, 75k, 10, 50k, 11, 1)
;noise V(Vn) V2 dec 100 1 100k
3
2
1
3
2
1
