BerryAudio/BGP/BGP_J0/FINAL/JFET_B.asc

C1: cap; 100µ; V=6.3 Rser=0.9
C2: cap; 1n
C3: cap; 2.7n
C4: cap; 47µ
C5: cap; 1µ
C6: cap; 0.47µ
C7: cap; 0.1µ
C8: cap; 1µ
C9: cap; 47µ
C10: cap; 270p
C11: cap; 270p
C12: cap; 0.1µ
C13: cap; 47n
C14: cap; 270p
C19: cap; 0.1µ
C20: cap; 270p
J1: njf; J2N5457
J2: njf; J2N5457
J3: njf; J2N5457
R1: res; 100k
R2: res; 10k
R3: res; 125k
R4: res; 1Meg
R5: res; 3.9k
R6: res; 10k
R7: res; 10k
R8: res; 15k
R9: res; 1
R10: res; 25k
R11: res; 25k
R12: res; 1.8k
R13: res; 125k
R14: res; 1k
R15: res; 1Meg
R16: res; 4.7k
R17: res; 10k
R18: res; 1k
R19: res; 125k
R20: res; 125k
R21: res; 1Meg
R22: res; 20k
R23: res; 10k
R24: res; 250k
R26: res; 100
R27: res; 1Meg
R29: res; 1
R35: res; 250k
V1: voltage; 9
V2: voltage; SINE(0 0.6 1k); AC 1 0
Named nets: 0, V+, Vi1, Vr, Vbuf, Vstack, Vn
.inc ./jfet.lib
;tran 0 100m 0m 1u
.ac dec 100 1 100k
.step param Rx list 1 2 3 4 5 6 7 8 9
.param R1 table(Rx, 1, 1, 2, 390, 3, 780, 4, 1.56k, 5, 3.125k, 6, 6.25k, 7, 12.5k, 8, 25k, 9, 50k)
.param R2 table(Rx, 1, 50k, 2, 25k, 3, 12.5k, 4, 6.25k, 5, 3.125k, 6, 1.56k, 7, 780, 8, 390, 9, 1)
;noise V(Vn) V2 dec 100 20 20k
NOTES:
R18: 5k trim pot
NOTES:
R8: 5k trim pot
R12: 5k trim pot
1. INPUTS
2. TONE STACK
3. VOLUME/TONE
TREBLE: R9 LOW, R10 HIGH
