BerryAudio/BGP/BGP_F0/FINAL/CB_BGP_V0.asc

C1: cap; 100p
C2: cap; 22µ
C3: cap; 0.1µ
C4: cap; 10µ
C5: cap; 0.1µ
C6: cap; 10µ
C7: cap; 22n
C8: cap; 10n
C9: cap; 10µ
C10: cap; 0.1µ
C11: cap; 10n
C12: cap; 100p
C13: cap; 100p
C14: cap; 10µ
C15: cap; 22n
C16: cap; 270p
C17: cap; 10µ
C18: cap; 270p
J1: njf; J2N5457
J2: njf; J2N5457
R1: res; 20k
R2: res; 100k
R3: res; 1Meg
R4: res; 330k
R5: res; 1Meg
R6: res; {R1/2}
R7: res; 330k
R8: res; {R2/2}
R9: res; 10k
R10: res; 100k
R11: res; {R2/2}
R12: res; {R1/2}
R13: res; 100k
R14: res; 100k
R15: res; 12k
R16: res; 25k
R17: res; 10k
R18: res; 10k
R19: res; 1
R20: res; 1.8k
R21: res; 6.8k
R22: res; 6.8k
R23: res; 1.8k
R24: res; 25k
R25: res; 25k
R26: res; 1.8k
R27: res; 22k
R28: res; 22k
R29: res; 20k
R30: res; 20k
R31: res; 10k
R32: res; 10k
R33: res; 1k
R34: res; 100
R35: res; 1K
R36: res; 20k
R37: res; 47k
R38: res; 1k
R39: res; 4.7k
R40: res; {R1*2}
R41: res; {R1*2}
R42: res; 4.7k
U1: LT1352
U2: LT1352
U3: LT1352
U5: LT1352
V1: voltage; 9
V2: voltage; SINE(0 0.5 1k); AC 1
V3: voltage; SINE(0 0.5 1k); AC 1
Named nets: 0, V+, Vn, Mr, Mi, Mo, Vr
.inc ./jfet.lib
;tran 0 100m 0 1u
.ac dec 100 1 1meg
OPA180
RK0971210Z2M: MOUSER
PTD902-2215K-B203: DIGIKEY
MC33178/TS512
.step param Rx list 1 2 3 4 5 6 7 8 9 10 11
.param R1 table(Rx, 1, 1, 2, 10k, 3, 20k, 4, 30k, 5, 40k, 6, 50k, 7, 60k, 8, 70k, 9, 80k, 10, 90k, 11, 100k)
.param R2 table(Rx, 1, 100k, 2, 90k, 3, 80k, 4, 70k, 5, 60k, 6, 50k, 7, 40k, 8, 30k, 9, 20k, 10, 10k, 11, 1)
.param R3 table(Rx, 1, 20k, 2, 10k, 3, 5k, 4, 2.5k, 5, 160, 6, 80, 7, 400, 8, 20, 9, 1)
;noise V(Vn) V3 dec 100 1 100k
SMALL BEAR ELECTRONICS CONCENTRIC POTS
OPA180
