BerryAudio/BGP/BGP_J0/FINAL/TONE.asc

C1: cap; 47n
R1: res; {Rx*250}
R2: res; 125k
R3: res; 125k
R4: res; 1K
V1: voltage; SINE(0 1 1k); AC 1
Named nets: 0
.step param Rx list 1 2 4 8 16 32 63 125 250 375  750 1000
.ac oct 100 1 100k
