BerryAudio/BGP/BGP_F1/FINAL/SVF.asc

C1: cap; 0.1µ
C2: cap; 0.01µ
C3: cap; 0.01µ
C4: cap; 10µ
C5: cap; 0.1µ
C6: cap; 0.01µ
C7: cap; 0.01µ
C8: cap; 10µ
C9: cap; 2.7n
C11: cap; 22n
C12: cap; 10µ
C13: cap; 100p
C14: cap; 22µ
C15: cap; 100p
R1: res; 2.49k
R2: res; 1
R3: res; 470k
R4: res; 470k
R5: res; 100k
R6: res; 100k
R7: res; 4.7k
R8: res; {X}
R9: res; 4.7k
R10: res; {X}
R11: res; 2.4k
R12: res; 20k
R13: res; 27k
R14: res; 27k
R15: res; 20k
R16: res; 1
R17: res; 27k
R18: res; 27k
R19: res; 470k
R20: res; 470k
R21: res; 4.7k
R22: res; {X}
R23: res; 4.7k
R24: res; {X}
R25: res; 20k
R26: res; 27k
R27: res; 27k
R28: res; 20k
R29: res; 27k
R30: res; 27k
R31: res; 25k
R32: res; 75k
R33: res; 47k
R34: res; 75k
R35: res; 4.7k
R36: res; 1
R37: res; 100
R38: res; {Y}
R39: res; 10k
R40: res; 24k
R41: res; 4.7k
R42: res; 4.7k
R43: res; 47k
R44: res; 25k
R45: res; 24k
R46: res; 24k
R47: res; 100
R48: res; 47k
R50: res; 1
R51: res; 20k
R52: res; 12k
R53: res; 10k
U1: LT1352
U2: LT1352
U3: LT1352
U4: LT1352
U5: LT1352
U6: LT1352
U7: LT1352
U8: LT1352
U9: LT1352
U10: LT1352
V1: voltage; SINE(0 1 1k); AC 1; Rser=12k
V2: voltage; 9
V3: voltage; SINE(0 1 1k); AC 1; Rser=12k
Named nets: 0, Vr, V+, Vn
.ac dec 100 1 100k
;tran 0 100m 0 1u
.step param X list 100k 50k 25k 12.5k 6.25k 3.125k 1.5625k 0.78125k 0.390625k 1
.step param Y list 100k 90k 80k 70k 60k 50k 40k 30k 20k 10k 1
;noise V(Vn) V1 dec 100 20 20k
.inc jfet.lib
