BerryAudio/BGP/BGP_J0/FINAL/JFET_C.asc

C1: cap; 47µ
C2: cap; 0.1µ
C3: cap; 27p
C4: cap; 47µ
C5: cap; 1µ
J1: njf; J202
R1: res; 100k
R2: res; 10k
R3: res; 249k
R4: res; 1Meg
R5: res; 6.8k
R6: res; 3.9k
R8: res; 10k
R14: res; 100k
V1: voltage; 9
V2: voltage; SINE(0 0.3 1k); AC 1 0
Named nets: 0, V+, Vi, Vr
.tran 0 100m 0 1u
.inc ./jjfet.lib
.inc ./jfet.lib
;ac dec 100 1 100k
