BerryAudio/BGP/BGP_F0/FINAL/CB_BGP_BLEND.asc

C1: cap; 27p
C2: cap; 22µ
C3: cap; 0.1µ
C4: cap; 10µ
C5: cap; 0.1µ
C6: cap; 10µ
C9: cap; 10µ
C12: cap; 27p
C13: cap; 100p
J1: njf; J2N5457
J2: njf; J2N5457
R3: res; 1.5Meg
R4: res; 390k
R5: res; 1.5Meg
R6: res; {R1*2}
R7: res; 390k
R8: res; {R2*2}
R9: res; 10k
R10: res; 100k
R11: res; {R2*2}
R12: res; {R1*2}
R14: res; 100k
R15: res; 15k
R17: res; 10k
R18: res; 10k
R29: res; 20k
R30: res; 20k
R33: res; 1k
R37: res; 47k
R38: res; 1k
U1: LT1352
U2: LT1352
V1: voltage; 9
V2: voltage; SINE(0 0.5 1k); AC 1
V3: voltage; SINE(0 0.5 1k); AC 1
Named nets: 0, V+, Vr, Vn
.inc ./jfet.lib
;tran 0 100m 0 1u
;ac dec 100 1 100k
OPA180
RK0971210Z2M: MOUSER
PTD902-2215K-B203: DIGIKEY
.step param Rx list 1 2 3 4 5 6 7 8 9 10 11
.param R1 table(Rx, 1, 1, 2, 6.25k, 3, 12.5k, 4, 18.75k, 5, 25k, 6, 31.25k, 7, 37.5k, 8, 43.75k, 9, 50k)
.param R2 table(Rx, 1, 50k, 2, 43.75k, 3, 37.5k, 4, 31.25k, 5, 25k, 6, 18.75k, 7, 12.5k, 8, 6.25k, 9, 1)
.noise V(Vn) V3 dec 100 1 100k
OPA180
