BerryAudio/BGP/BGP_J0/FINAL/JFET_A.asc

C1: cap; 10µ
C2: cap; 10µ
C3: cap; 2.7n
C4: cap; 10µ
C5: cap; 1µ
C6: cap; 470n
C7: cap; 0.1µ
C8: cap; 10µ
C9: cap; 47µ
C10: cap; 47p
C11: cap; 270p
C12: cap; 0.1µ
C13: cap; 47n
C14: cap; 0.1µ
C15: cap; 47p
C16: cap; 10µ
C17: cap; 0.1µ
C18: cap; 47p
C19: cap; 0.1µ
C20: cap; 270p
C21: cap; 10µ
J1: njf; J201
J2: njf; J201
J3: njf; J201
J4: njf; J201
J5: njf; J201
R1: res; 100k
R2: res; 10k
R3: res; 1k
R4: res; 1Meg
R5: res; 4.99k
R6: res; 10k
R7: res; 10k
R8: res; 1.5k
R9: res; {R1/2}
R10: res; {R2/2}
R11: res; {R2/2}
R12: res; 1.5k
R14: res; 100
R15: res; 1Meg
R16: res; 4.99k
R17: res; 10k
R18: res; 1.5k
R19: res; 1Meg
R20: res; 99k
R21: res; 1Meg
R22: res; 4.99k
R23: res; 1k
R24: res; 25k
R26: res; 12.5k
R27: res; 249k
R28: res; 99k
R29: res; 10k
R30: res; 12.5k
R31: res; 1Meg
R32: res; 1k
R33: res; 249k
R34: res; 4.99k
R35: res; 10k
V1: voltage; 9
V2: voltage; SINE(0 0.1 1k); AC 1 0
V3: voltage; SINE(0 0.1 1k); AC 1 0
Named nets: 0, V+, Vi1, Vr, Vi2, Vbuf, Vstack, Vvol, Vn
.inc ./jfet.lib
;tran 0 100m 0 1u
.ac dec 100 1 100k
.step param Rx list 1 2 3 4 5 6 7 8 9 10 11
.param R1 table(Rx, 1, 1, 2, 6.25k, 3, 12.5k, 4, 18.75k, 5, 25k, 6, 31.25k, 7, 37.5k, 8, 43.75k, 9, 50k)
.param R2 table(Rx, 1, 50k, 2, 43.75k, 3, 37.5k, 4, 31.25k, 5, 25k, 6, 18.75k, 7, 12.5k, 8, 6.25k, 9, 1)
.inc ./jjfet.lib
;noise V(Vn) V2 dec 100 20 200k
NOTES:
1. Move Volume to other side of source follower;
2. Mixing, put 1k resistor on output of each blend pot.
NOTES:
R18: 5k trim pot
NOTES:
R8: 5k trim pot
R12: 5k trim pot
1. INPUTS
2. TONE STACK
3. VOLUME
4. TONE
