BerryAudio/BGP/BGP_F0/FINAL/MID_POT.asc

C3: cap; 10n
C4: cap; 4.7n
C5: cap; 100µ
R3: res; 22k
R4: res; 22k
R5: res; 1
R6: res; 10k
R7: res; {R1*2}
R8: res; 11k
R9: res; 11k
R10: res; {R1*2}
U1: LT1352
V1: voltage; 9
V2: voltage; 9
V3: voltage; SINE(0 1 1k); AC 1
Named nets: V+, 0, V-
.step param Rx list 1 2 3 4 5 6 7 8 9 10 11
.param R1 table(Rx, 1, 1, 2, 6.25k, 3, 12.5k, 4, 18.75k, 5, 25k, 6, 31.25k, 7, 37.5k, 8, 43.75k, 9, 50k)
.param R2 table(Rx, 1, 50k, 2, 43.75k, 3, 37.5k, 4, 31.25k, 5, 25k, 6, 18.75k, 7, 12.5k, 8, 6.25k, 9, 1)
;tran 0 5m 0 0.1u
.ac dec 100 1 100k
