BerryAudio/BGP/(list of files, drawings)

Other design files:
BGP_F0/BT_STACK_v1.1/BT_STACK.dsn
BGP_F0/BUF_v1.1/BUF.dsn
BGP_F0/OLD/BT_STACK/BT_STACK.dsn
BGP_F0/OLD/BUF/BUF.dsn
BGP_F1/BUF/BUF.dsn
BGP_F1/VOL/VOL.dsn
BGP_J0/BT/BT.dsn
BGP_J0/VOL/VOL.dsn
BGP_MM/MID_STACK/MID_STACK.dsn
