BerryAudio/BGP/BGP_J0/BT/BT.kicad_pcb

## KiCad design BGP_J0/BT/BT.kicad_pcb (2018-08-28)

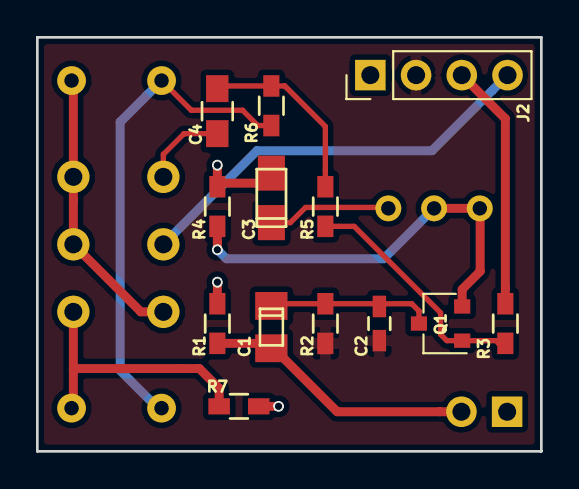
[picture p5: board BGP_J0/BT/BT.kicad_pcb from above]

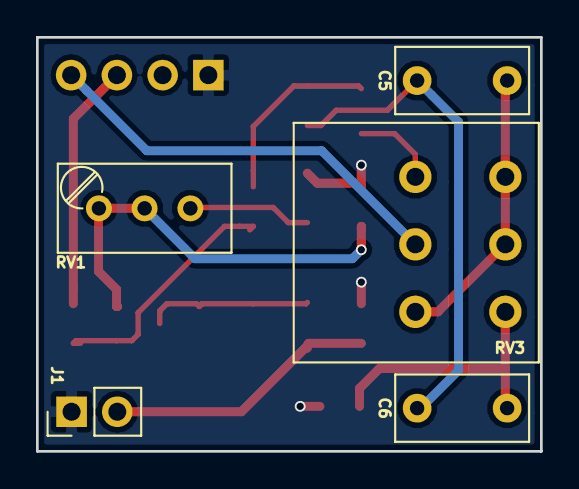
[picture p6: board BGP_J0/BT/BT.kicad_pcb from below]

Board: 2 copper layers, 28.0 x 23.0 mm, 18 parts (5 on the bottom side), 14 nets.

Parts:
C1: 0.1u; TantalC_SizeR_EIA-2012
C2: 270p; C_0603_HandSoldering
C3: 47u; TantalC_SizeS_EIA-3216
C4: 2700p; C_0805_HandSoldering
C5: 1u; C_Rect_L7.2mm_W3.5mm_P5.00mm_FKS2_FKP2_MKS2_MKP2
C6: 0.33u; C_Rect_L7.2mm_W3.5mm_P5.00mm_FKS2_FKP2_MKS2_MKP2
J1: Conn_01x02_Male; PinHeader_1x02_P2.54mm_Vertical
J2: Conn_01x04_Male; PinHeader_1x04_P2.54mm_Vertical
Q1: MMBF5457; SC-59
R1: NF; R_0603_HandSoldering
R2: 1Meg; R_0603_HandSoldering
R3, R6: 10k; R_0603_HandSoldering
R4: 3.9k; R_0603_HandSoldering
R5: 1k; R_0603_HandSoldering
R7: 1.8k; R_0603_HandSoldering
RV1: POT; Potentiometer_Trimmer_Bourns_3296W
RV3: DUAL_POT; Potentiometer_Alpha_Double_Vertical_Dual_Shaft

Connections:
/IN: C1.2, J1.2, R1.1
/RV_1: C6.2, R7.1, RV3.1
/RV_2: C5.2, RV3.2, RV3.3, RV3.4
/RV_5: J2.4, RV3.5
/RV_6: C4.2, RV3.6
/Vref: C2.2, J2.2, R2.2
Earth: C3.2, J1.1, J2.1, R1.2, R4.2, R7.2
unnamed: C1.1, C2.1, Q1.3, R2.1
unnamed: C3.1, RV1.3
unnamed: C4.1, R5.1, R6.1
unnamed: C5.1, C6.1, R6.2
unnamed: Q1.1, R3.2, R5.2
unnamed: Q1.2, R4.1, RV1.1, RV1.2
VCC: J2.3, R3.1
