BerryAudio/BGP/BGP_J0/BND/BND.kicad_pcb

## KiCad design BGP_J0/BND/BND.kicad_pcb (2018-08-28)

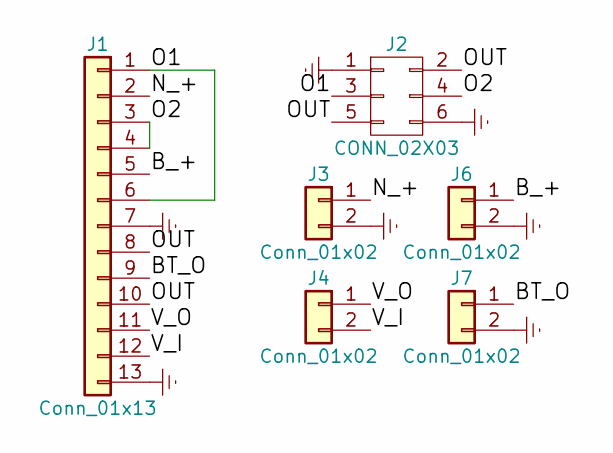
[picture p7: schematic BND.sch]

Parts:
J1: Conn_01x13; Bournes_Blend_PP
J2: CONN_02X03; Pin_Header_Straight_2x03
J3, J6: Conn_01x02; TerminalBlock_Phoenix_MPT-2.54mm_2pol
J4, J7: Conn_01x02; Pin_Header_Straight_1x02

Connections:
/BT_O: J1.9, J7.1
/B_+: J1.5, J6.1
/N_+: J1.2, J3.1
/O1: J1.1, J1.6, J2.3
/O2: J1.3, J1.4, J2.4
/OUT: J1.8, J1.10, J2.2, J2.5
/V_I: J1.12, J4.2
/V_O: J1.11, J4.1
Earth: J1.7, J1.13, J2.1, J2.6, J3.2, J6.2, J7.2

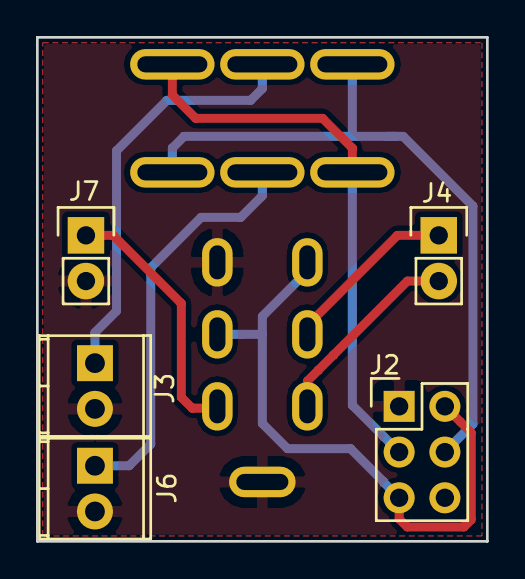
[picture p8: board BND.kicad_pcb from above]

Board: 2 copper layers, 25.0 x 28.0 mm, 6 parts (1 on the bottom side), 9 nets.
