BerryAudio/BGP/BGP_J0/VOL/VOL.kicad_pcb

## KiCad design BGP_J0/VOL/VOL.kicad_pcb (2018-08-27)

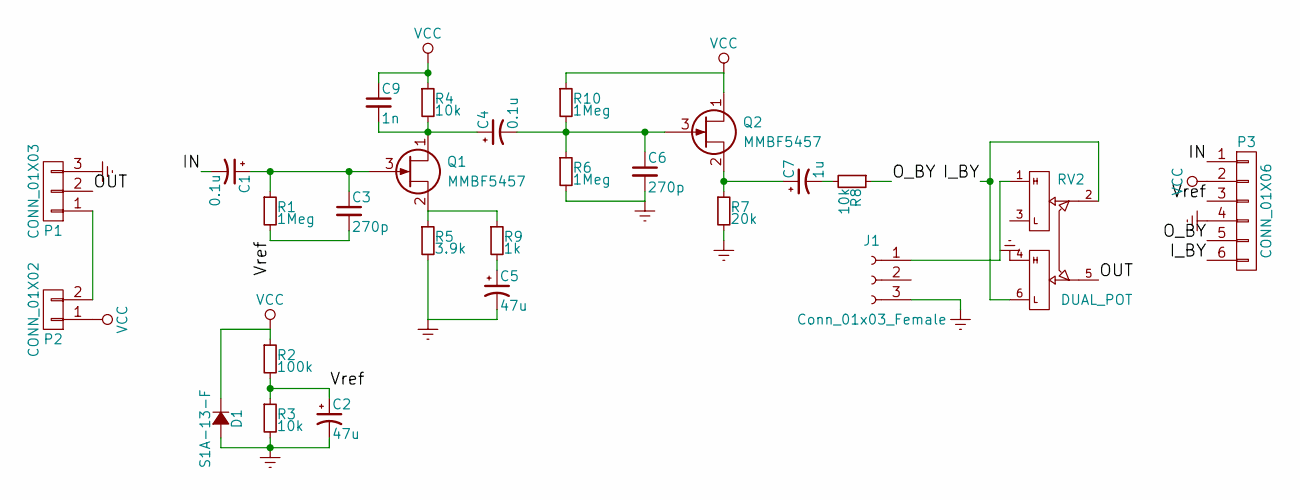
[picture p9: schematic VOL.sch]

Parts:
C1, C4: 0.1u; TantalC_SizeR_EIA-2012
C2, C5: 47u; TantalC_SizeS_EIA-3216
C3, C6: 270p; C_0603_HandSoldering
C7: 1u; TantalC_SizeR_EIA-2012
C9: 1n; C_0805
D1: S1A-13-F; SMA_Standard
J1: Conn_01x03_Female; Pin_Header_Straight_1x03_Pitch2.54mm
P1: CONN_01X03; TerminalBlock_Pheonix_MPT-2.54mm_3pol
P2: CONN_01X02; TerminalBlock_Pheonix_MPT-2.54mm_2pol
P3: CONN_01X06; Pin_Header_Straight_1x06
Q1, Q2: MMBF5457; SC-59
R1, R6, R10: 1Meg; R_0603_HandSoldering
R2: 100k; R_0603_HandSoldering
R3, R4, R8: 10k; R_0603_HandSoldering
R5: 3.9k; R_0603_HandSoldering
R7: 20k; R_0603_HandSoldering
R9: 1k; R_0603_HandSoldering
RV2: DUAL_POT; Potentiometer_Alpha_Double_Vertical_Dual_Shaft

Connections:
/IN: C1.2, P3.1
/I_BY: P3.6, RV2.2, RV2.6
/OUT: P1.2, RV2.5
/O_BY: P3.5, R8.1
/Vref: C2.1, C3.2, P3.3, R1.2, R2.2, R3.1
Earth: C2.2, C5.2, C6.2, D1.2 (A), J1.3, P1.3, P3.4, R3.2, R5.2, R6.2, R7.2, RV2.4
unnamed: C1.1, C3.1, Q1.3 (G), R1.1
unnamed: C4.1, C9.2, Q1.1 (D), R4.2
unnamed: C4.2, C6.1, Q2.3 (G), R6.1, R10.2
unnamed: C5.1, R9.2
unnamed: C7.1, Q2.2 (S), R7.1
unnamed: C7.2, R8.2
unnamed: J1.1, RV2.1
unnamed: P1.1, P2.2
unnamed: Q1.2 (S), R5.1, R9.1
VCC: C9.1, D1.1 (K), P2.1, P3.2, Q2.1 (D), R2.1, R4.1, R10.1

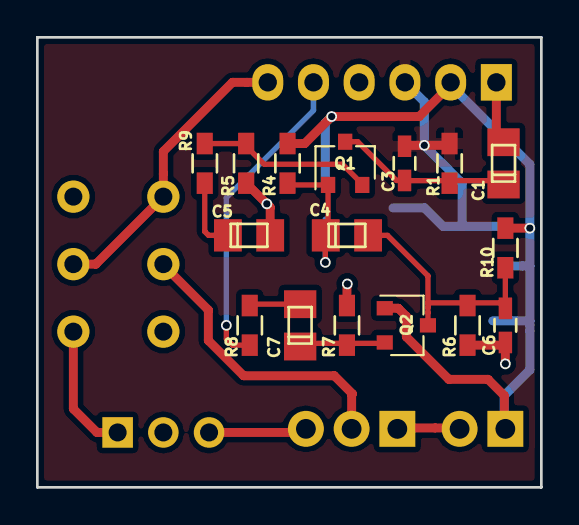
[picture p10: board BGP_J0/VOL/VOL.kicad_pcb from above]

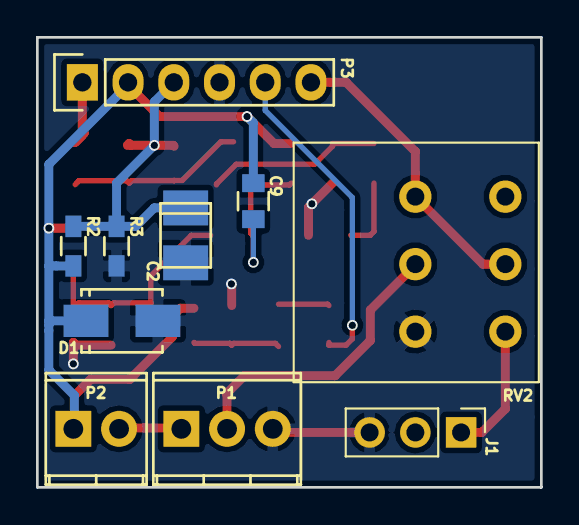
[picture p11: board BGP_J0/VOL/VOL.kicad_pcb from below]

Board: 2 copper layers, 28.0 x 25.0 mm, 26 parts (10 on the bottom side), 16 nets.
