BerryAudio/BGP/BGP_MM/BT/BT.kicad_pcb

## KiCad design BGP_MM/BT/BT.kicad_pcb (2018-06-14)

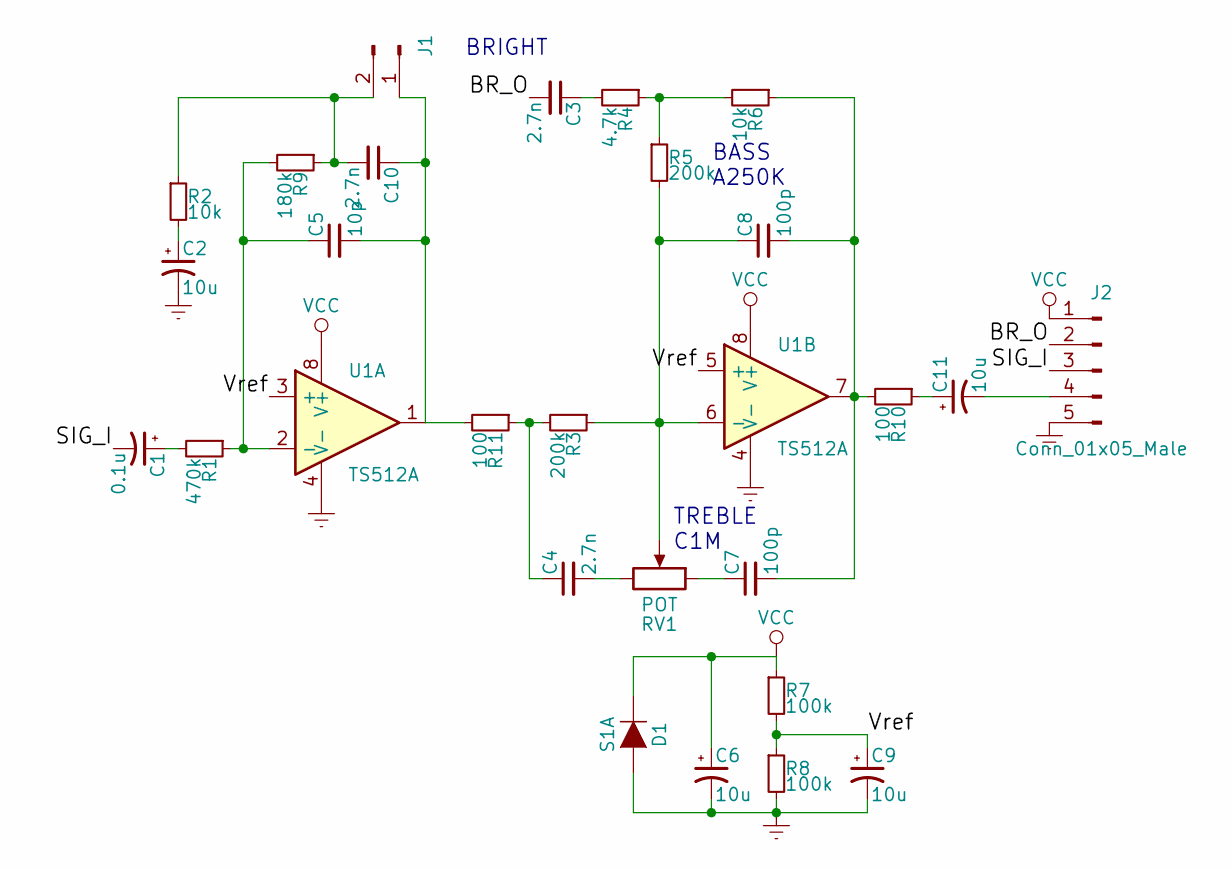
[picture p12: schematic BT.sch]

Parts:
C1: 0.1u; C_0805
C2, C11: 10u; C_0805
C3, C4, C10: 2.7n; C_0805
C5: 10p; C_0603_HandSoldering
C6, C9: 10u; C_1206
C7, C8: 100p; C_0603_HandSoldering
D1: S1A; SMA_Standard
J1: Conn_01x02_Male; Pin_Header_Straight_1x02
J2: Conn_01x05_Male; Pin_Header_Straight_1x05_Pitch2.54mm
R1: 470k; C_0603_HandSoldering
R2, R6: 10k; C_0603_HandSoldering
R3, R5: 200k; C_0603_HandSoldering
R4: 4.7k; C_0603_HandSoldering
R7, R8: 100k; C_0603_HandSoldering
R9: 180k; C_0603_HandSoldering
R10, R11: 100; C_0603_HandSoldering
RV1: POT; Potentiometer_Alpha_RV16
U1: TS512A; SOIC-8-N

Connections:
/BR_O: C3.2, J2.2
/SIG_I: C1.2, J2.3
/Vref: C9.1, R7.2, R8.1, U1.3 (+), U1.5 (+)
Earth: C2.2, C6.2, C9.2, D1.2 (A), J2.5, R8.2, U1.4 (V-)
unnamed: C1.1, R1.2
unnamed: C2.1, R2.2
unnamed: C3.1, R4.2
unnamed: C4.1, R3.2, R11.1
unnamed: C4.2, RV1.3
unnamed: C5.1, R1.1, R9.2, U1.2 (-)
unnamed: C7.1, RV1.1
unnamed: C7.2, C8.2, R6.1, R10.2, U1.7
unnamed: C8.1, R3.1, R5.2, RV1.2, U1.6 (-)
unnamed: C5.2, C10.1, J1.1, R11.2, U1.1
unnamed: C10.2, J1.2, R2.1, R9.1
unnamed: C11.1, R10.1
unnamed: C11.2, J2.4
unnamed: R4.1, R5.1, R6.2
VCC: C6.1, D1.1 (K), J2.1, R7.1, U1.8 (V+)

Notes on the sheet:
BRIGHT
BASS A250K
TREBLE C1M

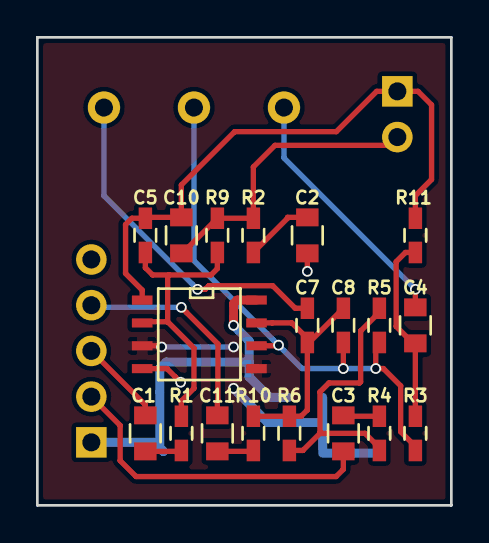
[picture p13: board BGP_MM/BT/BT.kicad_pcb from above]

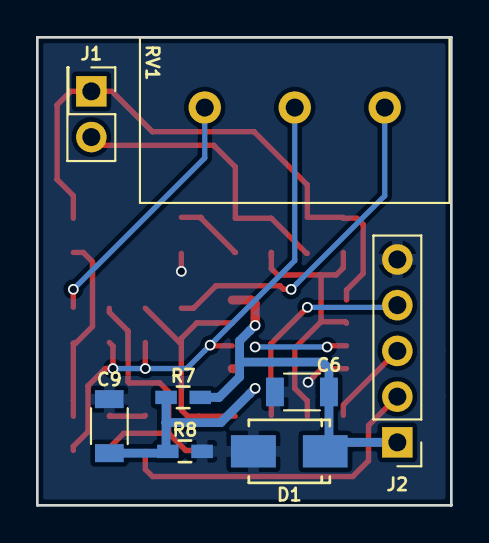
[picture p14: board BGP_MM/BT/BT.kicad_pcb from below]

Board: 2 copper layers, 23.0 x 26.0 mm, 27 parts (8 on the bottom side), 19 nets.
