BerryAudio/BGP/BGP_F0/BT_STACK_v1.1/BT_STACK.kicad_pcb

## KiCad design BGP_F0/BT_STACK_v1.1/BT_STACK.kicad_pcb (2018-06-13)

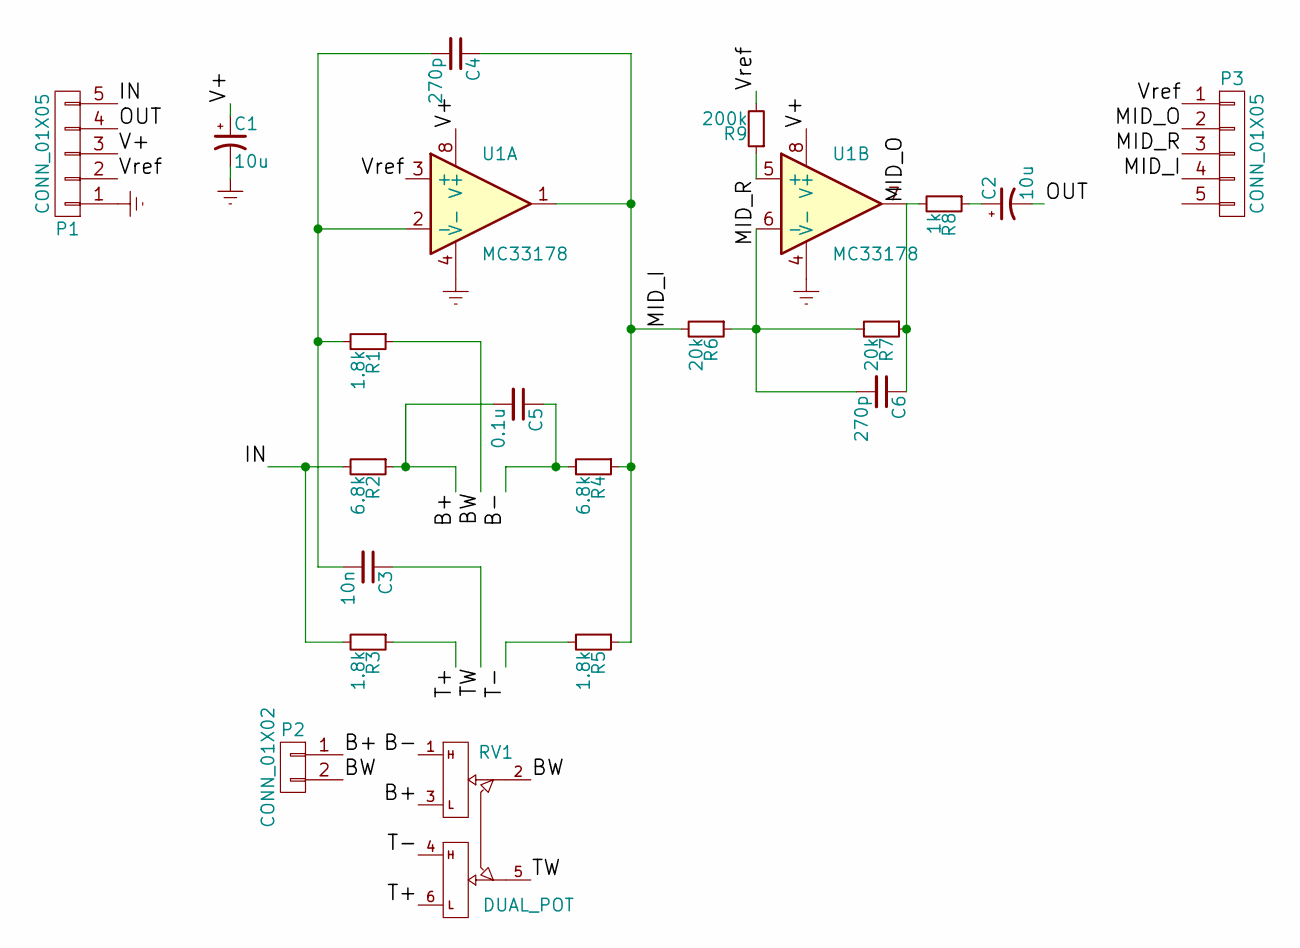
[picture p15: schematic BT_STACK.sch]

Parts:
C1: 10u; C_1206_HandSoldering
C2: 10u; C_0805_HandSoldering
C3: 10n; C_0805_HandSoldering
C4, C6: 270p; C_0603_HandSoldering
C5: 0.1u; C_0805_HandSoldering
P1, P3: CONN_01X05; Pin_Header_Straight_1x05
P2: CONN_01X02; Pin_Header_Straight_1x02_Pitch2.54mm
R1, R3, R5: 1.8k; R_0603_HandSoldering
R2, R4: 6.8k; R_0603_HandSoldering
R6, R7: 20k; R_0603_HandSoldering
R8: 1k; R_0603_HandSoldering
R9: 200k; R_0603_HandSoldering
RV1: DUAL_POT; Potentiometer_Alpha_Double_Vertical_Dual_Shaft
U1: MC33178; SOIC-8_3.9x4.9mm_Pitch1.27mm

Connections:
/B+: C5.2, P2.1, R2.1, RV1.3
/B-: C5.1, R4.2, RV1.1
/BW: P2.2, R1.1, RV1.2
/IN: P1.5, R2.2, R3.2
/MID_I: C4.1, P3.4, R4.1, R5.1, R6.2, U1.1
/MID_O: C6.1, P3.2, R7.1, R8.2, U1.7
/MID_R: P3.3, R9.1, U1.5 (+)
/OUT: C2.2, P1.4
/T+: R3.1, RV1.6
/T-: R5.2, RV1.4
/TW: C3.1, RV1.5
/V+: C1.1, P1.3, U1.8 (V+)
/Vref: P1.2, P3.1, R9.2, U1.3 (+)
Earth: C1.2, P1.1, U1.4 (V-)
unnamed: C2.1, R8.1
unnamed: C3.2, C4.2, R1.2, U1.2 (-)
unnamed: C6.2, R6.1, R7.2, U1.6 (-)

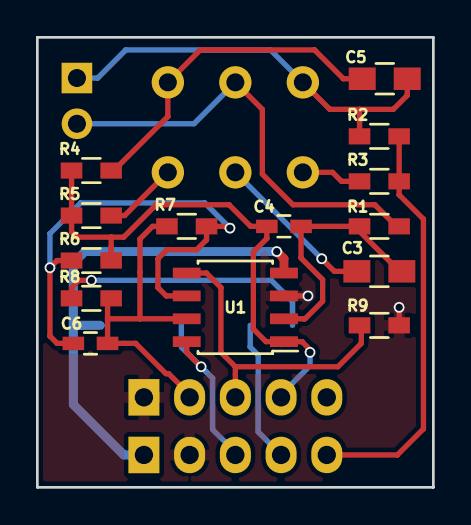
[picture p16: board BT_STACK.kicad_pcb from above]

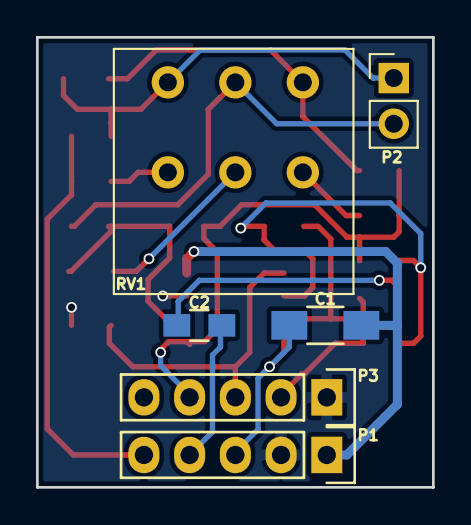
[picture p17: board BT_STACK.kicad_pcb from below]

Board: 2 copper layers, 22.0 x 25.0 mm, 20 parts (6 on the bottom side), 17 nets.
