BerryAudio/BGP/BGP_F0/BUF_v1.1/BUF.kicad_pcb

## KiCad design BGP_F0/BUF_v1.1/BUF.kicad_pcb (2018-06-13, an earlier design)

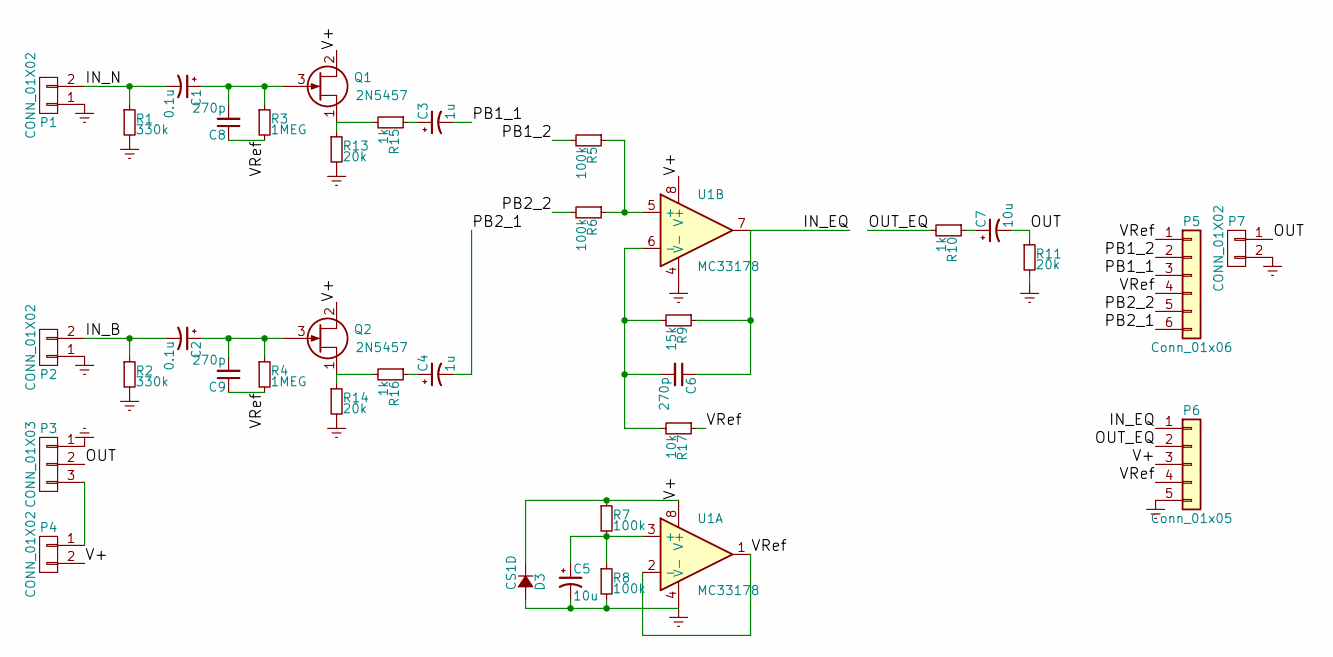
[picture p18: schematic BUF.sch]

Parts:
C1, C2: 0.1u; C_0805
C3, C4: 1u; C_0805
C5: 10u; C_1206
C6, C8, C9: 270p; C_0603
C7: 10u; C_0805
D3: CS1D; D_SMA
P1, P2, P4: CONN_01X02; TerminalBlock_Pheonix_MPT-2.54mm_2pol
P3: CONN_01X03; TerminalBlock_Pheonix_MPT-2.54mm_3pol
P5: Conn_01x06; Potentiometer_Alpha_Double_Vertical_Dual_Shaft
P6: Conn_01x05; Pin_Header_Straight_1x05
P7: CONN_01X02; Pin_Header_Straight_1x02
Q1, Q2: 2N5457; SC-59
R1, R2: 330k; R_0603
R3, R4: 1MEG; R_0603
R5, R6, R7, R8: 100k; R_0603
R9: 15k; R_0603
R10, R15, R16: 1k; R_0603
R11, R13, R14: 20k; R_0603
R17: 10k; R_0603
U1: MC33178; SOIC-8_3.9x4.9mm_Pitch1.27mm

Connections:
/IN_B: C2.2, P2.2, R2.1
/IN_EQ: C6.1, P6.1, R9.1, U1.7
/IN_N: C1.2, P1.2, R1.1
/OUT: C7.2, P3.2, P7.1, R11.1
/OUT_EQ: P6.2, R10.2
/PB1_1: C3.2, P5.3
/PB1_2: P5.2, R5.2
/PB2_1: C4.2, P5.6
/PB2_2: P5.5, R6.2
/V+: D3.1 (K), P4.2, P6.3, Q1.2 (D), Q2.2 (D), R7.1, U1.8 (V+)
/VRef: C8.1, C9.1, P5.1, P5.4, P6.4, R3.2, R4.2, R17.1, U1.1, U1.2 (-)
Earth: C5.2, D3.2 (A), P1.1, P2.1, P3.1, P6.5, P7.2, R1.2, R2.2, R8.2, R11.2, R13.2, R14.2, U1.4 (V-)
unnamed: C1.1, C8.2, Q1.3 (G), R3.1
unnamed: C2.1, C9.2, Q2.3 (G), R4.1
unnamed: C3.1, R15.1
unnamed: C4.1, R16.1
unnamed: C5.1, R7.2, R8.1, U1.3 (+)
unnamed: C6.2, R9.2, R17.2, U1.6 (-)
unnamed: C7.1, R10.1
unnamed: P3.3, P4.1
unnamed: Q1.1 (S), R13.1, R15.2
unnamed: Q2.1 (S), R14.1, R16.2
unnamed: R5.1, R6.1, U1.5 (+)

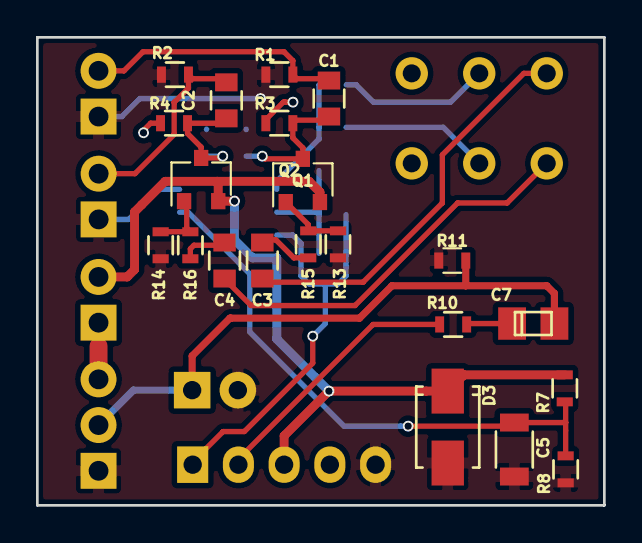
[picture p19: board BGP_F0/BUF_v1.1/BUF.kicad_pcb from above]

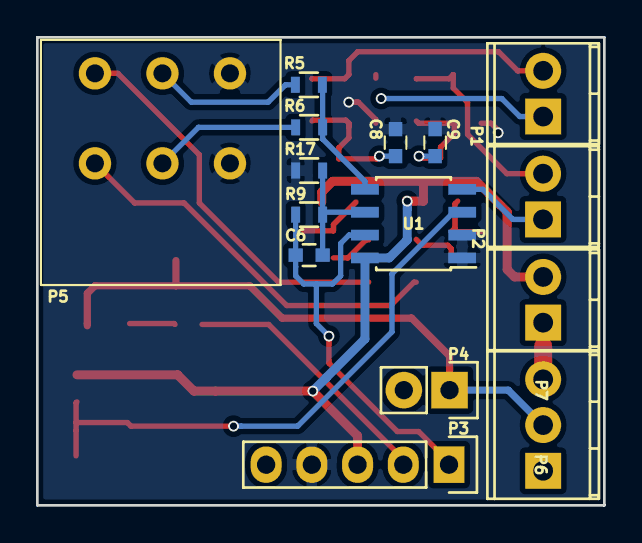
[picture p20: board BGP_F0/BUF_v1.1/BUF.kicad_pcb from below]

Board: 2 copper layers, 31.5 x 26.0 mm, 36 parts (15 on the bottom side), 23 nets.
