BerryAudio/BGP/BGP_MM/SW_BR/SW_BR.kicad_pcb

## KiCad design BGP_MM/SW_BR/SW_BR.kicad_pcb (2018-06-13)

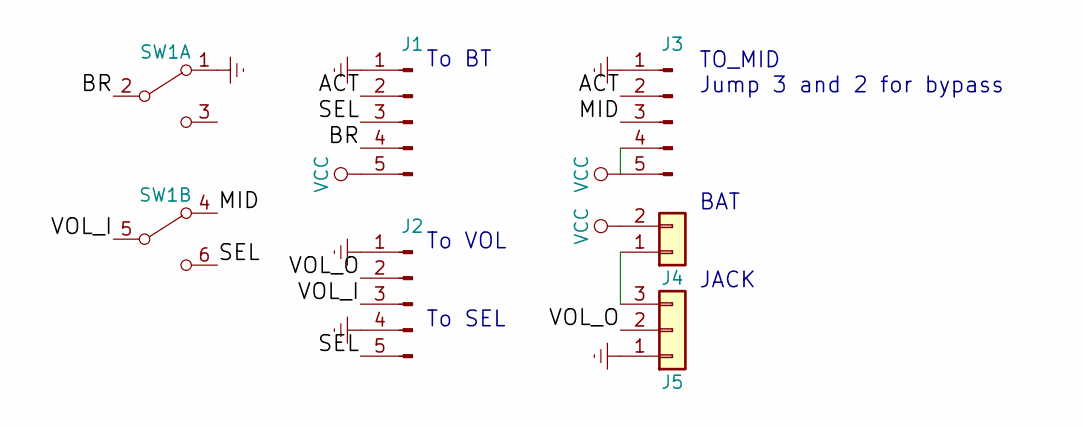
[picture p21: schematic SW_BR.sch]

Parts:
J1, J2, J3: Conn_01x05_Male; Pin_Header_Straight_1x05_Pitch2.54mm
J4: Conn_01x02; TerminalBlock_Phoenix_MPT-2.54mm_2pol
J5: Conn_01x03; TerminalBlock_Phoenix_MPT-2.54mm_3pol
SW1: SW_DPDT; NKK_DPDT

Connections:
/ACT: J1.2, J3.2
/BR: J1.4, SW1.2 (B)
/MID: J3.3, SW1.4 (A)
/SEL: J1.3, J2.5, SW1.6 (C)
/VOL_I: J2.3, SW1.5 (B)
/VOL_O: J2.2, J5.2
Earth: J1.1, J2.1, J2.4, J3.1, J5.1, SW1.1 (A)
unnamed: J4.1, J5.3
VCC: J1.5, J3.4, J3.5, J4.2

Notes on the sheet:
To BT
To SEL
To VOL
TO_MID Jump 3 and 2 for bypass
BAT
JACK

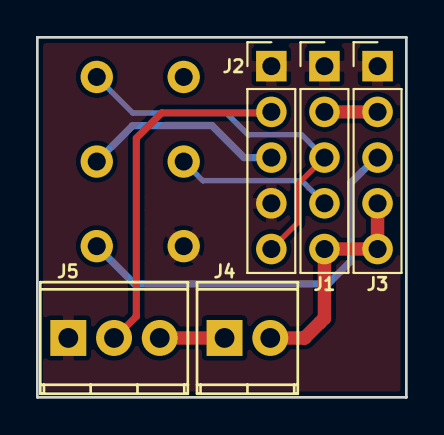
[picture p22: board SW_BR.kicad_pcb from above]

Board: 2 copper layers, 20.5 x 20.0 mm, 6 parts (1 on the bottom side), 9 nets.
