BerryAudio/BGP/BGP_MM/SW_MM/SW_MM.kicad_pcb

## KiCad design BGP_MM/SW_MM/SW_MM.kicad_pcb (2018-06-13)

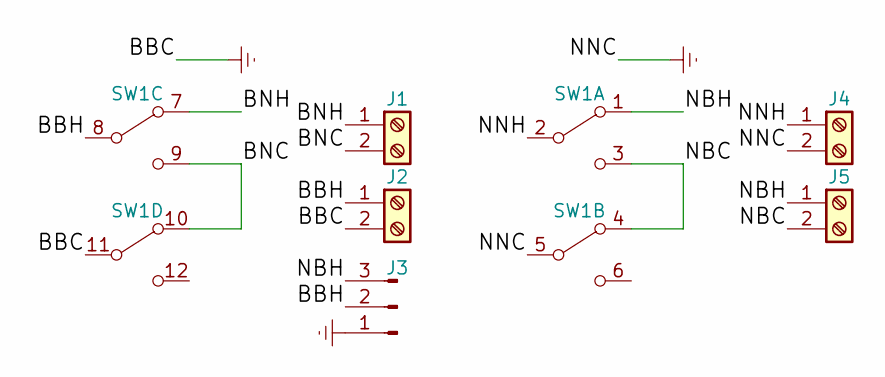
[picture p23: schematic SW_MM.sch]

Parts:
J1, J2, J4, J5: Screw_Terminal_01x02; TerminalBlock_Phoenix_MPT-2.54mm_2pol
J3: Conn_01x03_Male; Pin_Header_Straight_1x03_Pitch2.54mm
SW1: SW_4PDT; NKK_DP3T

Connections:
/BBH: J2.1, J3.2, SW1.8 (B)
/BNC: J1.2, SW1.9 (C), SW1.10 (A)
/BNH: J1.1, SW1.7 (A)
/NBC: J5.2, SW1.3 (C), SW1.4 (A)
/NBH: J3.3, J5.1, SW1.1 (A)
/NNH: J4.1, SW1.2 (B)
Earth: J2.2, J3.1, J4.2, SW1.5 (B), SW1.11 (B)
