BerryAudio/BGP/BGP_MM/SW_MM/SW_MM.kicad_pcb

## KiCad design BGP_MM/SW_MM/SW_MM.kicad_pcb (continued)

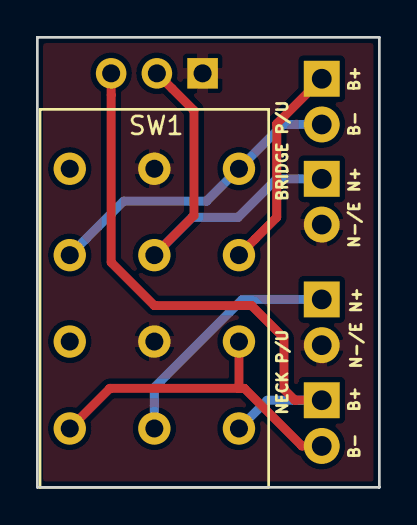
[picture p24: board SW_MM.kicad_pcb from above]

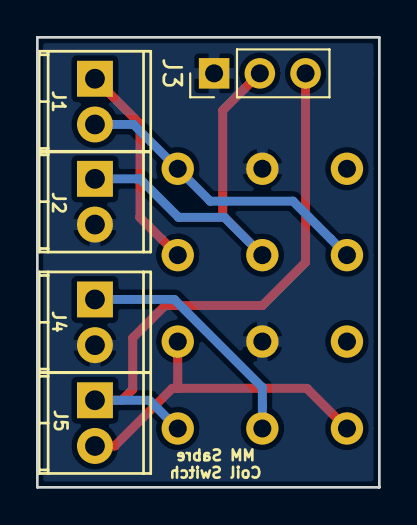
[picture p25: board SW_MM.kicad_pcb from below]

Board: 2 copper layers, 19.0 x 25.0 mm, 6 parts (5 on the bottom side), 7 nets.
