BerryAudio/BGP/BGP_F0/MID_STACK/MID_STACK.kicad_pcb

## KiCad design BGP_F0/MID_STACK/MID_STACK.kicad_pcb (2018-06-13)

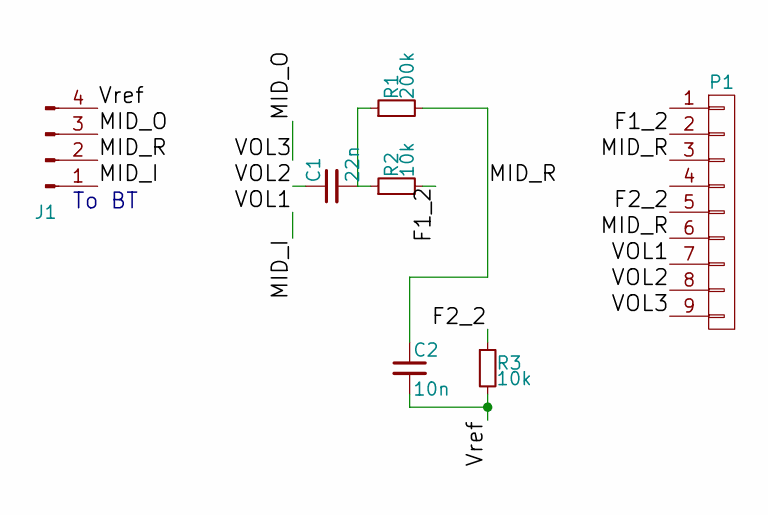
[picture p26: schematic MID_STACK.sch]

Parts:
C1: 22n; C_1206
C2: 10n; C_0805
J1: Conn_01x04_Male; Pin_Header_Straight_1x04
P1: CONN_01X09; Potentiometer_Alpha_Tripple_Vertical_Dual_Shaft
R1: 200k; R_0603_HandSoldering
R2, R3: 10k; R_0603_HandSoldering

Connections:
/F1_2: P1.2, R2.2
/F2_2: P1.5, R3.1
/MID_I: J1.1, P1.7
/MID_O: J1.3, P1.9
/MID_R: C2.1, J1.2, P1.3, P1.6, R1.2
/VOL2: C1.1, P1.8
/Vref: C2.2, J1.4, R3.2
unnamed: C1.2, R1.1, R2.1

Notes on the sheet:
To BT

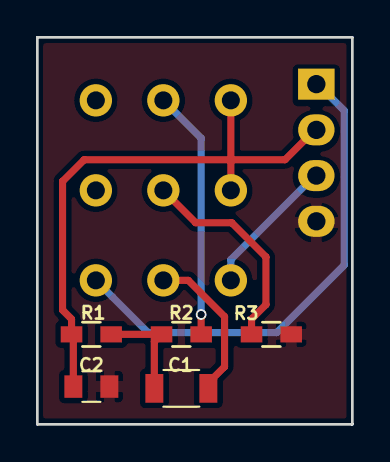
[picture p27: board BGP_F0/MID_STACK/MID_STACK.kicad_pcb from above]

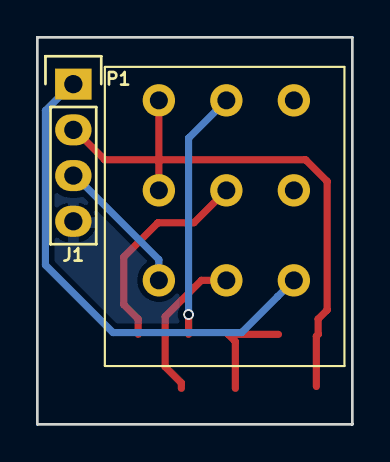
[picture p28: board BGP_F0/MID_STACK/MID_STACK.kicad_pcb from below]

Board: 2 copper layers, 17.5 x 21.5 mm, 7 parts (2 on the bottom side), 8 nets.
