BerryAudio/BGP/BGP_F0/VOL/VOL.kicad_pcb

## KiCad design BGP_F0/VOL/VOL.kicad_pcb (2018-06-12)

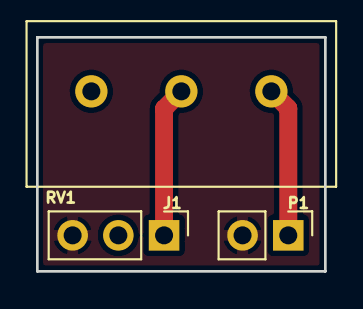
[picture p29: board BGP_F0/VOL/VOL.kicad_pcb from above]

Board: 2 copper layers, 16.0 x 13.0 mm, 3 parts (0 on the bottom side), 3 nets.

Parts:
J1: Conn_01x03_Female; Pin_Header_Straight_1x03_Pitch2.54mm
P1: CONN_01X02; Pin_Header_Straight_1x02_Pitch2.54mm
RV1: POT; Potentiometer_Alpha_RV16

Connections:
/VOL_1: P1.1, RV1.1
/VOL_3: J1.3, P1.2
unnamed: J1.1, RV1.2
