BerryAudio/BGP/BGP_MM/SW_SEL/SW_SEL.kicad_pcb

## KiCad design BGP_MM/SW_SEL/SW_SEL.kicad_pcb (2018-06-12)

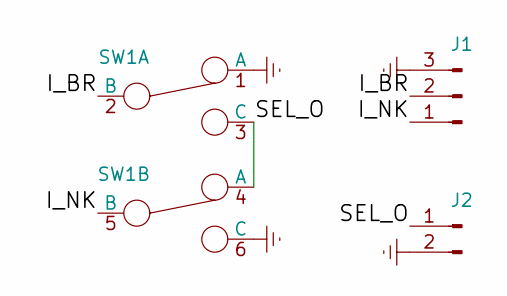
[picture p30: schematic SW_SEL.sch]

Parts:
J1: Conn_01x03_Male; Pin_Header_Straight_1x03_Pitch2.54mm
J2: Conn_01x02_Male; Pin_Header_Straight_1x02_Pitch2.54mm
SW1: Switch_SPDT_x2; NKK_DPDT

Connections:
/I_BR: J1.2, SW1.2 (B)
/I_NK: J1.1, SW1.5 (B)
/SEL_O: J2.1, SW1.3 (C), SW1.4 (A)
Earth: J1.3, J2.2, SW1.1 (A), SW1.6 (C)

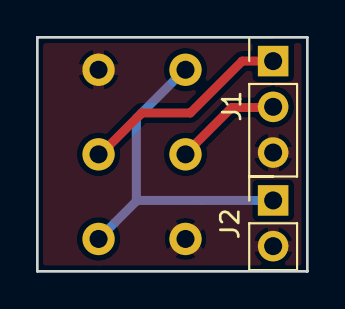
[picture p31: board SW_SEL.kicad_pcb from above]

Board: 2 copper layers, 15.0 x 13.0 mm, 3 parts (1 on the bottom side), 4 nets.
