BerryAudio/BGP/BGP_MM/MID_STACK/MID_STACK.kicad_pcb

## KiCad design BGP_MM/MID_STACK/MID_STACK.kicad_pcb (2018-06-12)

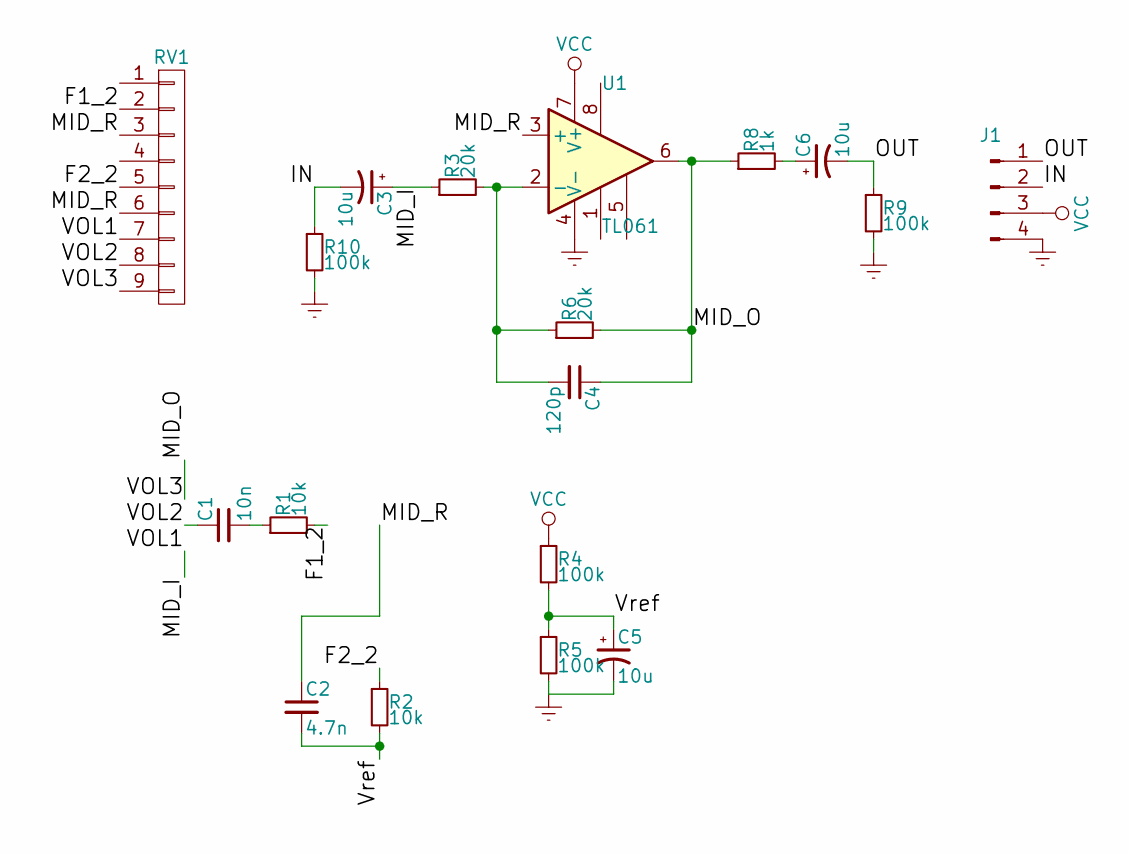
[picture p32: schematic MID_STACK.sch]

Parts:
C1: 10n; C_0805
C2: 4.7n; C_0805
C3, C5, C6: 10u; C_0805
C4: 120p; C_0603_HandSoldering
J1: Conn_01x04_Male; Pin_Header_Straight_2x02_Pitch2.54mm
R1, R2: 10k; R_0603_HandSoldering
R3, R6: 20k; R_0603_HandSoldering
R4, R5, R9, R10: 100k; R_0603_HandSoldering
R8: 1k; R_0603_HandSoldering
RV1: CONN_01X09; Potentiometer_Alpha_Tripple_Vertical_Dual_Shaft
U1: TL061; SOIC-8_3.9x4.9mm_Pitch1.27mm

Connections:
/F1_2: R1.2, RV1.2
/F2_2: R2.1, RV1.5
/IN: C3.2, J1.2, R10.1
/MID_I: C3.1, R3.1, RV1.7
/MID_O: C4.1, R6.2, R8.1, RV1.9, U1.6
/MID_R: C2.1, RV1.3, RV1.6, U1.3 (+)
/OUT: C6.2, J1.1, R9.1
/VOL2: C1.1, RV1.8
/Vref: C2.2, C5.1, R2.2, R4.2, R5.1
Earth: C5.2, J1.4, R5.2, R9.2, R10.2, U1.4 (V-)
unnamed: C1.2, R1.1
unnamed: C4.2, R3.2, R6.1, U1.2 (-)
unnamed: C6.1, R8.2
VCC: J1.3, R4.1, U1.7 (V+)

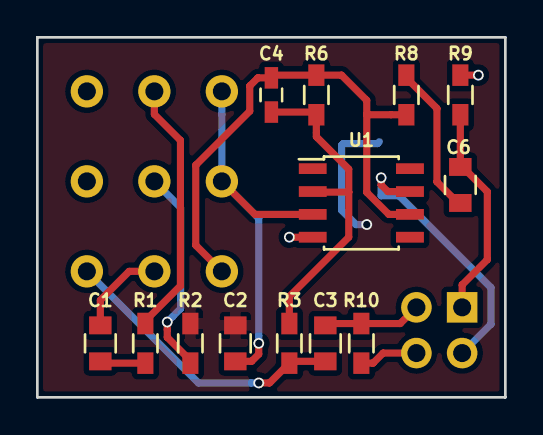
[picture p33: board BGP_MM/MID_STACK/MID_STACK.kicad_pcb from above]

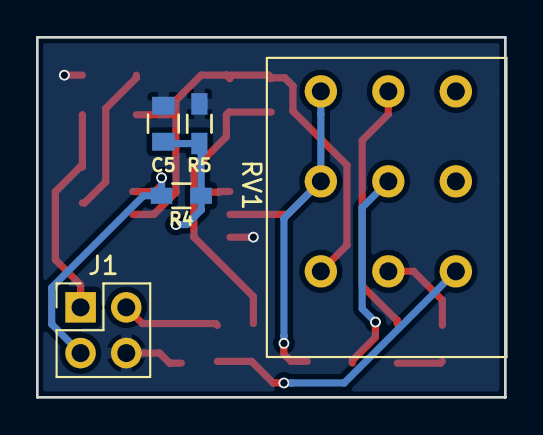
[picture p34: board BGP_MM/MID_STACK/MID_STACK.kicad_pcb from below]

Board: 2 copper layers, 26.0 x 20.0 mm, 18 parts (5 on the bottom side), 14 nets.
