BerryAudio/BGP/BGP_MM/SW_MM_4PTT/SW_MM_4PTT.kicad_pcb

## KiCad design BGP_MM/SW_MM_4PTT/SW_MM_4PTT.kicad_pcb (2018-06-07)

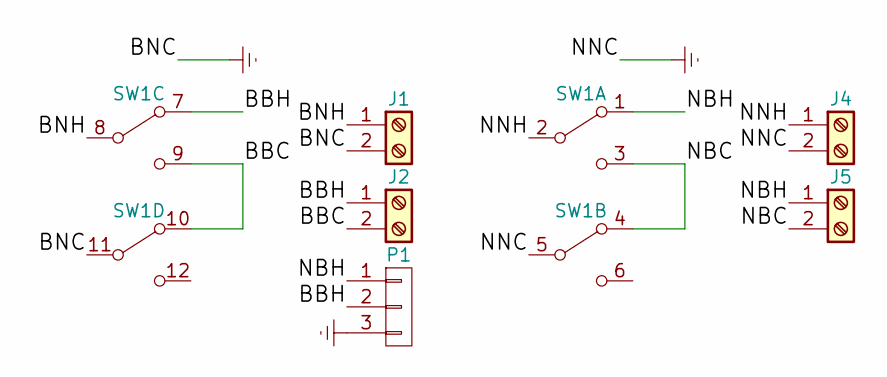
[picture p35: schematic SW_MM_4PTT.sch]

Parts:
J1, J2, J4, J5: Screw_Terminal_01x02; TerminalBlock_Phoenix_MPT-2.54mm_2pol
P1: CONN_01X03; JST_PH_B3B-PH-K_03x2.00mm_Straight
SW1: SW_4PDT_x4; NKK_DP3T

Connections:
/BBC: J2.2, SW1.9 (C), SW1.10 (A)
/BBH: J2.1, P1.2, SW1.7 (A)
/BNH: J1.1, SW1.8 (B)
/NBC: J5.2, SW1.3 (C), SW1.4 (A)
/NBH: J5.1, P1.1, SW1.1 (A)
/NNH: J4.1, SW1.2 (B)
Earth: J1.2, J4.2, P1.3, SW1.5 (B), SW1.11 (B)

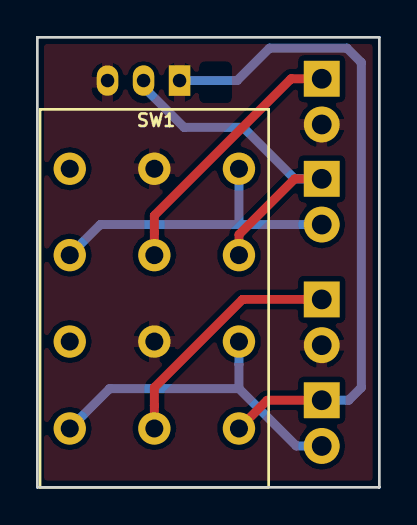
[picture p36: board SW_MM_4PTT.kicad_pcb from above]

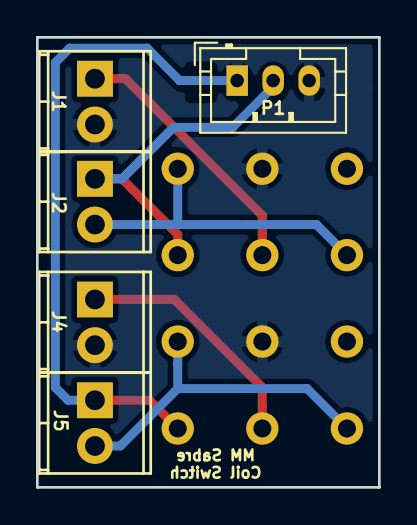
[picture p37: board SW_MM_4PTT.kicad_pcb from below]

Board: 2 copper layers, 19.0 x 25.0 mm, 6 parts (5 on the bottom side), 7 nets.
