BerryAudio/BGP/BGP_MM/SW_SEL_JZ/SW_SEL_JZ.kicad_pcb

## KiCad design BGP_MM/SW_SEL_JZ/SW_SEL_JZ.kicad_pcb (2018-06-05)

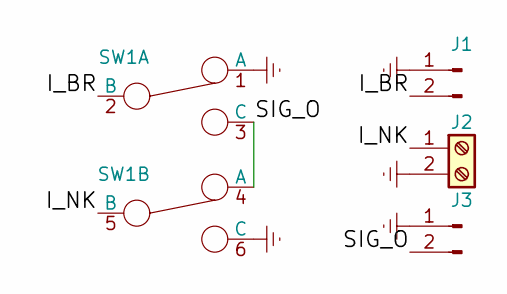
[picture p38: schematic SW_SEL_JZ.sch]

Parts:
J1, J3: Conn_01x02_Male; JST_PH_B2B-PH-K_02x2.00mm_Straight
J2: Screw_Terminal_01x02; TerminalBlock_Phoenix_MPT-2.54mm_2pol
SW1: Switch_SPDT_x2; NKK_DPDT

Connections:
/I_BR: J1.2, SW1.2 (B)
/I_NK: J2.1, SW1.5 (B)
/SIG_O: J3.2, SW1.3 (C), SW1.4 (A)
Earth: J1.1, J2.2, J3.1, SW1.1 (A), SW1.6 (C)

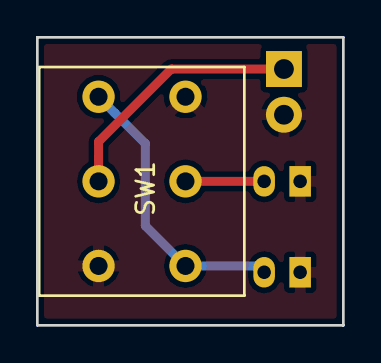
[picture p39: board SW_SEL_JZ.kicad_pcb from above]

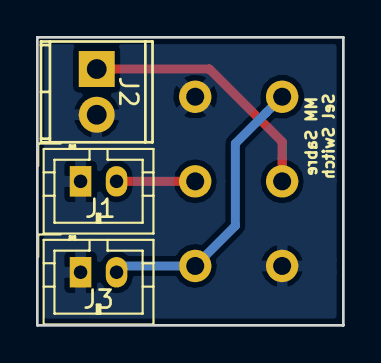
[picture p40: board SW_SEL_JZ.kicad_pcb from below]

Board: 2 copper layers, 17.0 x 16.0 mm, 4 parts (3 on the bottom side), 4 nets.
