BerryAudio/BGP/BGP_F1/HPF/HPF.kicad_pcb

## KiCad design BGP_F1/HPF/HPF.kicad_pcb (2018-04-13)

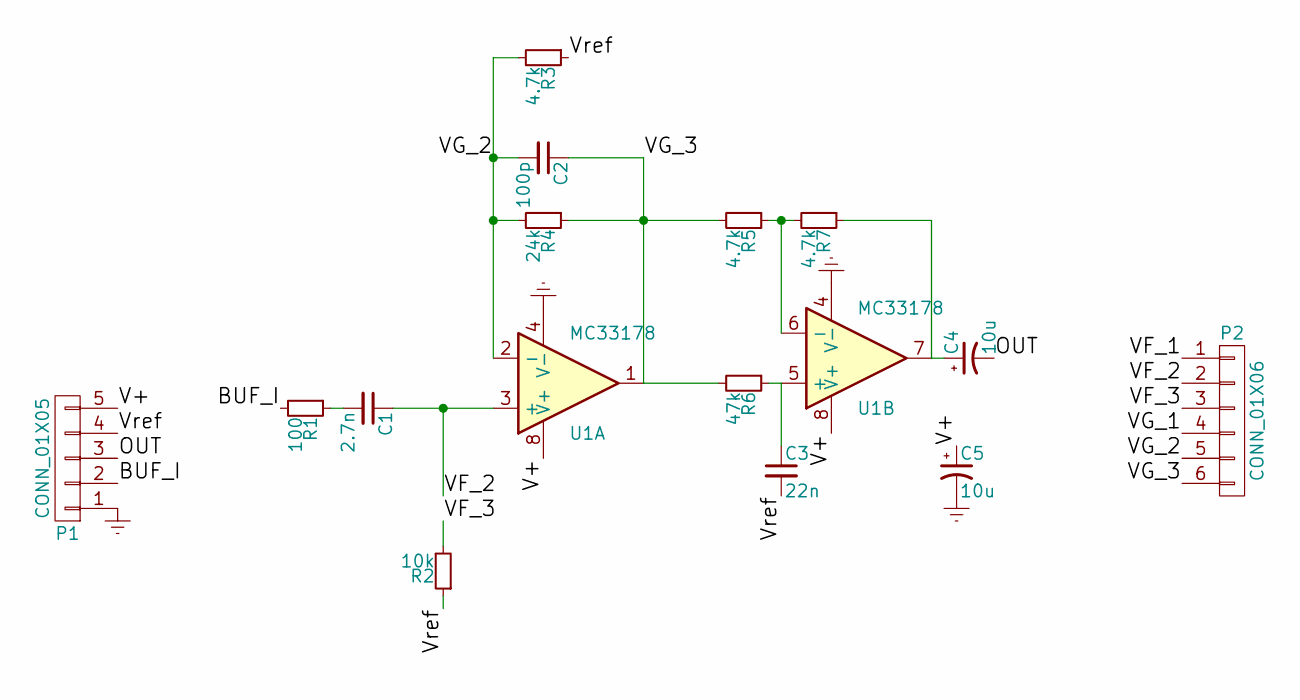
[picture p41: schematic HPF.sch]

Parts:
C1: 2.7n; C_0805_HandSoldering
C2: 100p; C_0805_HandSoldering
C3: 22n; C_1206_HandSoldering
C4, C5: 10u; TantalC_SizeR_EIA-2012
P1: CONN_01X05; JST_PH_B5B-PH-K_05x2.00mm_Straight
P2: CONN_01X06; Potentiometer_Alpha_Double_Vertical_Dual_Shaft
R1: 100; R_0603_HandSoldering
R2: 10k; R_0603_HandSoldering
R3, R5, R7: 4.7k; R_0603_HandSoldering
R4: 24k; R_0603_HandSoldering
R6: 47k; R_0603_HandSoldering
U1: MC33178; SOIC-8_3.9x4.9mm_Pitch1.27mm

Connections:
/BUF_I: P1.2, R1.2
/OUT: C4.2, P1.3
/V+: C5.1, P1.5, U1.8 (V+)
/VF_1: P2.1
/VF_2: C1.1, P2.2, U1.3 (+)
/VF_3: P2.3, R2.2
/VG_1: P2.4
/VG_2: C2.2, P2.5, R3.2, R4.2, U1.2 (-)
/VG_3: C2.1, P2.6, R4.1, R5.2, R6.2, U1.1
/Vref: C3.2, P1.4, R2.1, R3.1
Earth: C5.2, P1.1, U1.4 (V-)
unnamed: C1.2, R1.1
unnamed: C3.1, R6.1, U1.5 (+)
unnamed: C4.1, R7.1, U1.7
unnamed: R5.1, R7.2, U1.6 (-)

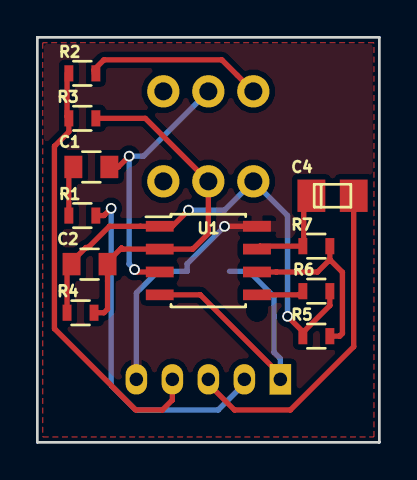
[picture p42: board HPF.kicad_pcb from above]

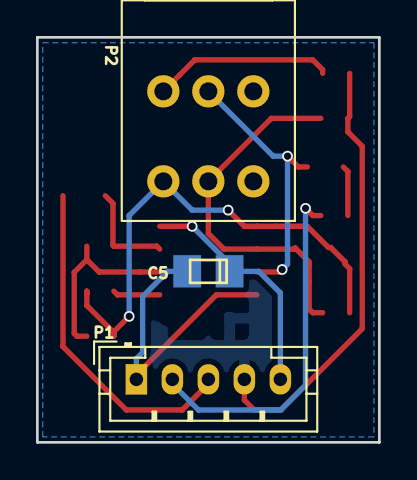
[picture p43: board HPF.kicad_pcb from below]

Board: 2 copper layers, 19.0 x 22.5 mm, 14 parts (3 on the bottom side), 13 nets.
