BerryAudio/BGP/BGP_F1/VOL/VOL.kicad_pcb

## KiCad design BGP_F1/VOL/VOL.kicad_pcb (2018-04-13)

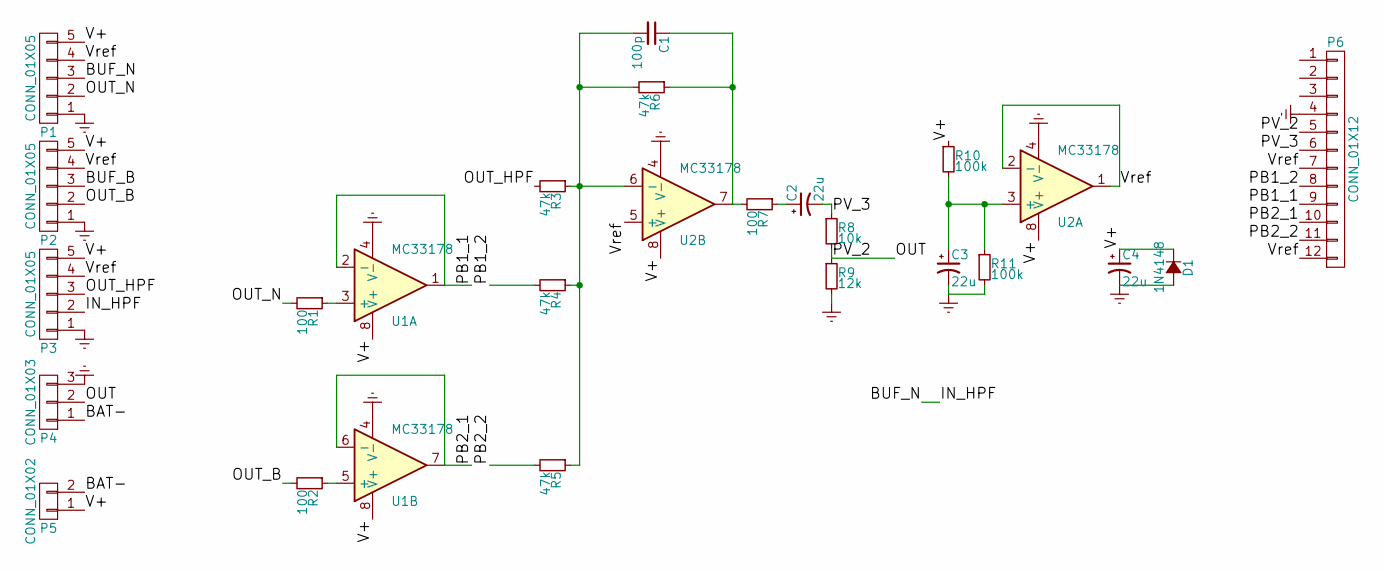
[picture p44: schematic VOL.sch]

Parts:
C1: 100p; C_0805
C2, C3, C4: 22u; TantalC_SizeS_EIA-3216
D1: 1N4148; SOD-123
P1: CONN_01X05; SMA_Standard
P2, P3: CONN_01X05; JST_PH_B5B-PH-K_05x2.00mm_Straight
P4: CONN_01X03; TerminalBlock_Pheonix_MPT-2.54mm_3pol
P5: CONN_01X02; TerminalBlock_Pheonix_MPT-2.54mm_2pol
P6: CONN_01X12; Potentiometer_Alps_RK097_Quad_Vertical_Dual_Shaft
R1, R2, R7: 100; R_0603
R3, R4, R5, R6: 47k; R_0603
R8: 10k; R_0603
R9: 12k; R_0603
R10, R11: 100k; R_0603
U1, U2: MC33178; SOIC-8_3.9x4.9mm_Pitch1.27mm

Connections:
/BAT-: P4.1, P5.2
/BUF_B: P2.3
/BUF_N: P1.3, P3.2
/OUT: P4.2, P6.5, R8.2, R9.1
/OUT_B: P2.2, R2.2
/OUT_HPF: P3.3, R3.2
/OUT_N: P1.2, R1.2
/PB1_1: P6.9, U1.1, U1.2 (-)
/PB1_2: P6.8, R4.2
/PB2_1: P6.10, U1.6 (-), U1.7
/PB2_2: P6.11, R5.2
/PV_3: C2.2, P6.6, R8.1
/V+: C4.1, D1.1 (K), P1.5, P2.5, P3.5, P5.1, R10.1, U1.8 (V+), U2.8 (V+)
/Vref: P1.4, P2.4, P3.4, P6.7, P6.12, U2.1, U2.2 (-), U2.5 (+)
Earth: C3.2, C4.2, D1.2 (A), P1.1, P2.1, P3.1, P4.3, P6.4, R9.2, R11.2, U1.4 (V-), U2.4 (V-)
unnamed: C1.1, R6.1, R7.2, U2.7
unnamed: C1.2, R3.1, R4.1, R5.1, R6.2, U2.6 (-)
unnamed: C2.1, R7.1
unnamed: C3.1, R10.2, R11.1, U2.3 (+)
unnamed: R1.1, U1.3 (+)
unnamed: R2.1, U1.5 (+)

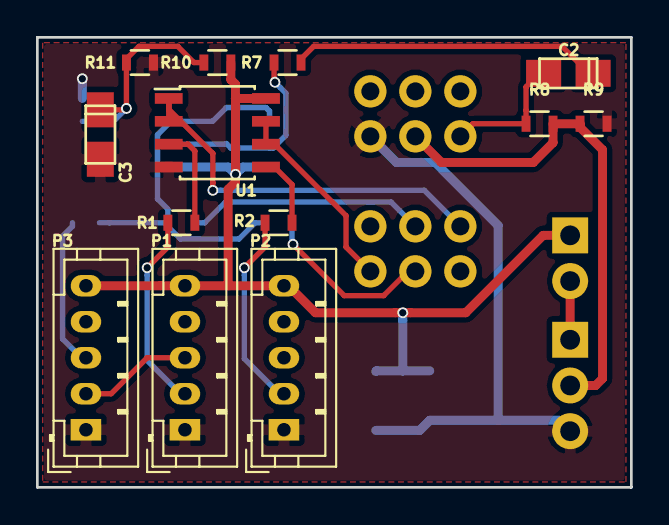
[picture p45: board BGP_F1/VOL/VOL.kicad_pcb from above]

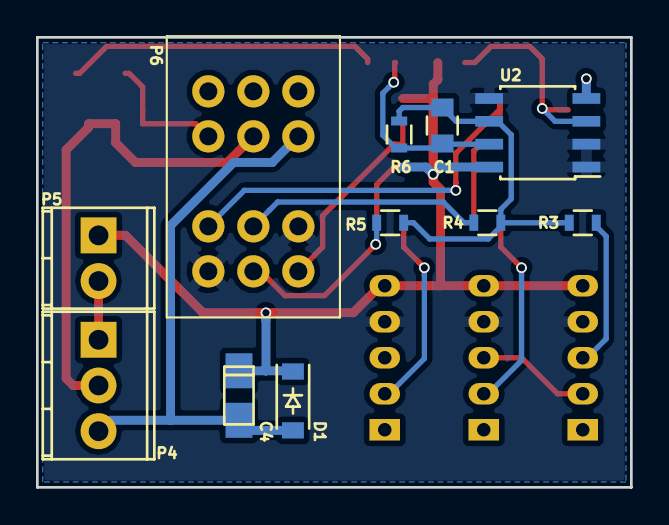
[picture p46: board BGP_F1/VOL/VOL.kicad_pcb from below]

Board: 2 copper layers, 33.0 x 25.0 mm, 24 parts (11 on the bottom side), 20 nets.
