BerryAudio/BGP/BGP_F1/BUF/BUF.kicad_pcb

## KiCad design BGP_F1/BUF/BUF.kicad_pcb (2018-04-11, an earlier design)

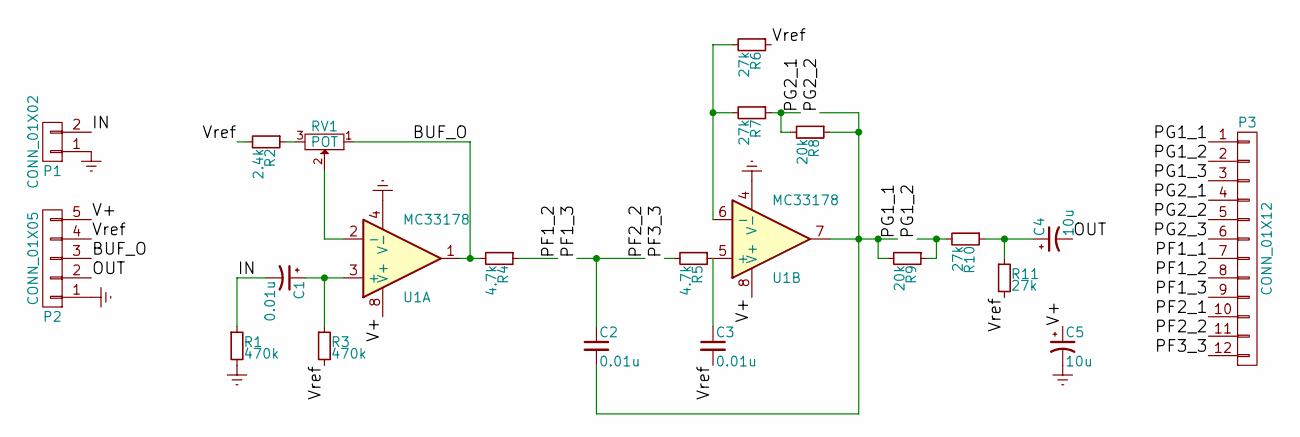
[picture p47: schematic BUF.sch]

Parts:
C1: 0.01u; TantalC_SizeR_EIA-2012
C2, C3: 0.01u; C_0805_HandSoldering
C4, C5: 10u; TantalC_SizeR_EIA-2012
P1: CONN_01X02; TerminalBlock_Pheonix_MPT-2.54mm_2pol
P2: CONN_01X05; JST_PH_B5B-PH-K_05x2.00mm_Straight
P3: CONN_01X12; Potentiometer_Alps_RK097_Quad_Vertical_Dual_Shaft
R1, R3: 470k; R_0603_HandSoldering
R2: 2.4k; R_0603_HandSoldering
R4, R5: 4.7k; R_0603_HandSoldering
R6, R7, R10, R11: 27k; R_0603_HandSoldering
R8, R9: 20k; R_0603_HandSoldering
RV1: POT; Potentiometer_Trimmer_Bourns_3296X
U1: MC33178; SOIC-8_3.9x4.9mm_Pitch1.27mm

Connections:
/BUF_O: P2.3, R4.2, RV1.1, U1.1
/IN: C1.2, P1.2, R1.1
/OUT: C4.2, P2.2
/PF1_1: P3.7
/PF1_2: P3.8, R4.1
/PF1_3: C2.1, P3.9, P3.11
/PF2_1: P3.10
/PF3_3: P3.12, R5.2
/PG1_1: C2.2, P3.1, P3.5, R8.1, R9.2, U1.7
/PG1_2: P3.2, R9.1, R10.2
/PG1_3: P3.3
/PG2_1: P3.4, R7.1, R8.2
/PG2_3: P3.6
/V+: C5.1, P2.5, U1.8 (V+)
/Vref: C3.2, P2.4, R2.2, R3.2, R6.1, R11.2
Earth: C5.2, P1.1, P2.1, R1.2, U1.4 (V-)
unnamed: C1.1, R3.1, U1.3 (+)
unnamed: C3.1, R5.1, U1.5 (+)
unnamed: C4.1, R10.1, R11.1
unnamed: R2.1, RV1.3
unnamed: R6.2, R7.2, U1.6 (-)
unnamed: RV1.2, U1.2 (-)

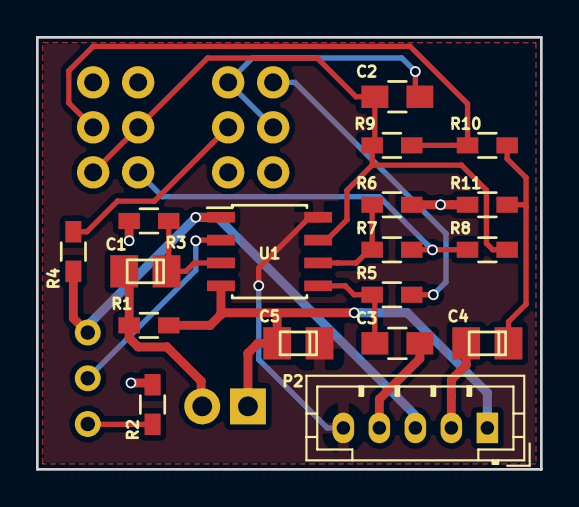
[picture p48: board BGP_F1/BUF/BUF.kicad_pcb from above]

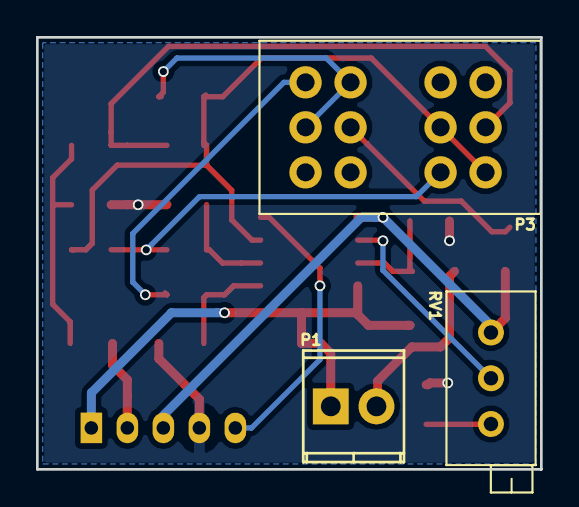
[picture p49: board BGP_F1/BUF/BUF.kicad_pcb from below]

Board: 2 copper layers, 28.0 x 24.0 mm, 21 parts (3 on the bottom side), 18 nets.
