BerryAudio/BGP/FET_TS/TST.kicad_pcb

## KiCad design FET_TS/TST.kicad_pcb (2018-02-28)

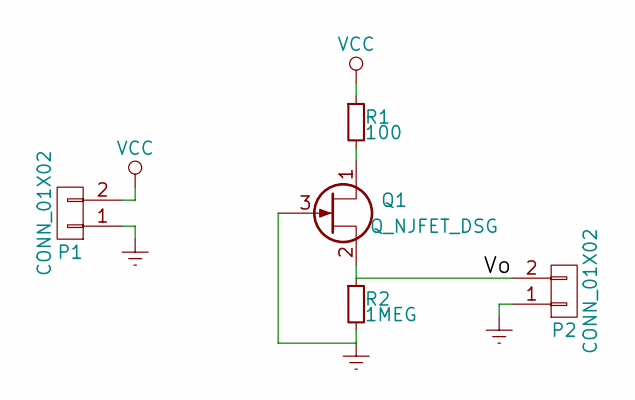
[picture p50: schematic TST.sch]

Parts:
P1, P2: CONN_01X02; Pin_Header_Straight_1x02
Q1: Q_NJFET_DSG; SOT-23_Handsoldering
R1: 100; R_0603_HandSoldering
R2: 1MEG; R_0603_HandSoldering

Connections:
/Vo: P2.2, Q1.2 (S), R2.1
Earth: P1.1, P2.1, Q1.3 (G), R2.2
unnamed: Q1.1 (D), R1.2
VCC: P1.2, R1.1

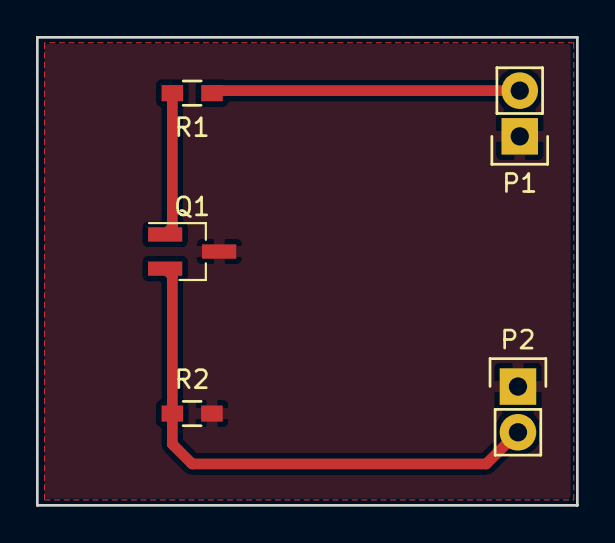
[picture p51: board TST.kicad_pcb from above]

Board: 2 copper layers, 30.0 x 26.0 mm, 5 parts (0 on the bottom side), 4 nets.
