BerryAudio/BGP/(commit log)

2018-01-11 First haul
    [A_BND_BUF-B.Cu.gbl, A_BND_BUF-B.Mask.gbs, A_BND_BUF-B.SilkS.gbo, A_BND_BUF-Edge.Cuts.gko, A_BND_BUF-F.Cu.gtl, A_BND_BUF-F.Mask.gts, A_BND_BUF-F.SilkS.gto, A_BND_BUF.drl]
2018-01-11 Gerbers
    Mainly getting gerbers ready. Issue with pots overlapping other boards in silk screens - top and bottom.
    [A_BND_BUF-B.Cu.gbl, A_BND_BUF-B.Mask.gbs, A_BND_BUF-B.SilkS.gbo, A_BND_BUF-Edge.Cuts.gm1, A_BND_BUF-F.Cu.gtl, A_BND_BUF-F.Mask.gts, A_BND_BUF-F.SilkS.gto, A_BND_BUF.drl]
2018-01-12 Pot fixups for silkscreen overlap
    [A_BND_BUF-B.Cu.gbl, A_BND_BUF-B.Mask.gbs, A_BND_BUF-B.SilkS.gbo, A_BND_BUF-Edge.Cuts.gm1, A_BND_BUF-F.Cu.gtl, A_BND_BUF-F.Mask.gts, A_BND_BUF-F.SilkS.gto, A_BND_BUF.drl]
2018-01-12 Concentric pot fixups for 0_BT Stack and 1_HPF
    [A_BND_BUF.kicad_pcb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]
2018-01-12 Concentric pot fixups for 1_BUF
    [BUF-B.Cu.gbl, BUF-B.Mask.gbs, BUF-B.SilkS.gbo, BUF-Edge.Cuts.gm1, BUF-F.Cu.gtl, BUF-F.Mask.gts, BUF-F.SilkS.gto, BUF.drl]
2018-01-12 BOM for V1 BGP
    [BOM.xlsx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]
2018-01-12 Further component refinement in V1
    [BOM.xlsx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]
2018-01-12 Gerbers updated
    [combined.gbl, combined.gbo, combined.gbs, combined.gm1, combined.gtl, combined.gto, combined.gts]
2018-01-12 V_0 Updates for caps, gerbers updated
    [A_BND_BUF-B.Cu.gbl, A_BND_BUF-B.Mask.gbs, A_BND_BUF-B.SilkS.gbo, A_BND_BUF-Edge.Cuts.gm1, A_BND_BUF-F.Cu.gtl, A_BND_BUF-F.Mask.gts, A_BND_BUF-F.SilkS.gto, A_BND_BUF.drl]
2018-01-13 some cleanup
    [BUF.kicad_pcb]
2018-01-14 V0 BUF and BT Edits
    V0 Buffer change from CRD to JFET CCS. BT stack changed to reflect +/- 9V changes.
    [A_BND_BUF-B.Cu.gbl, A_BND_BUF-B.Mask.gbs, A_BND_BUF-B.SilkS.gbo, A_BND_BUF-Edge.Cuts.gm1, A_BND_BUF-F.Cu.gtl, A_BND_BUF-F.Mask.gts, A_BND_BUF-F.SilkS.gto, A_BND_BUF.drl]
2018-01-14 Slight changes to Port layer placement - gerbers done
    [A_BND_BUF-B.Cu.gbl, A_BND_BUF-B.Mask.gbs, A_BND_BUF-B.SilkS.gbo, A_BND_BUF-Edge.Cuts.gm1, A_BND_BUF-F.Cu.gtl, A_BND_BUF-F.Mask.gts, A_BND_BUF-F.SilkS.gto, A_BND_BUF.drl]
2018-01-15 Some cleanup and gerbers updated to reflect this
    [BUF-B.Cu.gbl, BUF-B.Mask.gbs, BUF-B.SilkS.gbo, BUF-Edge.Cuts.gm1, BUF-F.Cu.gtl, BUF-F.Mask.gts, BUF-F.SilkS.gto, BUF.drl]
2018-01-15 Changed Mid sweep
    200 - 2k Hz
    [BOM.xlsx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]
2018-01-16 Error found/corrected in 1_VOL. Modified to use ALPS RK097 dual shaft, quad gang.
    [VOL-B.Cu.gbl, VOL-B.Mask.gbs, VOL-B.SilkS.gbo, VOL-Edge.Cuts.gm1, VOL-F.Cu.gtl, VOL-F.Mask.gts, VOL-F.SilkS.gto, VOL.drl]
2018-01-16 Changed 1_HPF to use ALPHA 12mm pot.
    [HPF-B.Cu.gbl, HPF-B.Mask.gbs, HPF-B.SilkS.gbo, HPF-Edge.Cuts.gm1, HPF-F.Cu.gtl, HPF-F.Mask.gts, HPF-F.SilkS.gto, HPF.drl]
2018-01-16 Reduced BT MID board sizes.
    [A_BND_BUF-Edge.Cuts.gko, A_BND_BUF-Edge.Cuts.gm1, BT_STACK-B.Cu.gbl, BT_STACK-B.Mask.gbs, BT_STACK-B.SilkS.gbo, BT_STACK-Edge.Cuts.gko, BT_STACK-Edge.Cuts.gm1, BT_STACK-F.Cu.gtl]
2018-01-17 New Filter deisgn - bug in previous
    [BOM.xlsx, BUF.kicad_pcb, BUF.sch, HPF.kicad_pcb, HPF.sch, VOL.dsn, VOL.kicad_pcb, VOL.sch]
2018-01-17 f1 pcb complete
    [VOL.dsn, VOL.kicad_pcb]
2018-01-17 F1 pcb trimmed
    [VOL.kicad_pcb]
2018-01-17 F1 VOL Prot Diode
    [VOL.kicad_pcb, VOL.sch]
2018-01-18 F boards routed, various optimisations made
    [BOM.xlsx, BUF.kicad_pcb, BUF.sch, HPF.kicad_pcb, HPF.sch, VOL.kicad_pcb, VOL.sch]
2018-01-18 Hand route F VOL board
    [VOL.kicad_pcb]
2018-01-18 Add some missing files
    [BUF.dsn]
2018-01-18 F VOL
    POT EARTH FIXUP
    [VOL.kicad_pcb, VOL.sch]
2018-01-18 Flipped boards so that they should be facing the right way
    [BUF.kicad_pcb, HPF.kicad_pcb, HPF.sch, VOL.kicad_pcb]
2018-01-19 Pot tinkering
    [BUF.kicad_pcb, BUF.sch, HPF.kicad_pcb, HPF.sch]
2018-01-19 Updated F_VOL
    Using 10kB, 100kA pot with correct orientation, and pot correction for blend.
    [VOL.kicad_pcb, VOL.sch, log.xlsx]
2018-01-22 New F0 Version
    [BUF.kicad_pcb, BUF.sch, HPF.kicad_pcb, HPF.sch, VOL.kicad_pcb, VOL.sch]
2018-01-22 F0 Buffer Board
    Buffer done. 30mm x 40mm, with optional outboard volume or concentric vol/blend. Output bypass EQ and straight to output possible.
    [BUF.dsn, BUF.kicad_pcb, BUF.sch]
2018-01-23 Added BT and MID. Mid not layed out yet
    [BT_STACK.dsn, BT_STACK.kicad_pcb, BT_STACK.sch, BUF.kicad_pcb, MID_STACK.dsn, MID_STACK.kicad_pcb, MID_STACK.sch]
2018-01-24 F0 BUF is now 26x40
    [BUF.dsn, BUF.kicad_pcb, BUF.sch, BUF_30x40.kicad_pcb]
2018-01-24 F0 Mid Stack done
    [MID_STACK.kicad_pcb, MID_STACK.sch]
2018-01-24 LOG Sim Spreadsheet
    [LOG_SIM.xlsx]
2018-01-24 F0 VOL Board Added
    [VOL.kicad_pcb, VOL.sch]
2018-01-24 F0 prot diode added, bt changed to 26mm
    [BT_STACK.kicad_pcb, BUF.kicad_pcb, BUF.sch]
2018-01-24 F0 - Volume Corrected
    [BUF.kicad_pcb, BUF.sch]
2018-01-24 Revert "F0 - Volume Corrected"
    This reverts commit ecfa2db017f63e3919b6c9b3f933c0864d41a2a5.
    [BUF.kicad_pcb, BUF.sch]
2018-01-25 Removed old boards, all F0 are now 26mm deep
    [A_BND_BUF.dsn, A_BND_BUF.kicad_pcb, A_BND_BUF.sch, BOM.xlsx, BT_STACK.dsn, BT_STACK.kicad_pcb, BT_STACK.sch, BUF.dsn]
2018-01-25 BT and MID pot gain ctrl reversed for proper action
    [BT_STACK.kicad_pcb, BT_STACK.sch, MID_STACK.kicad_pcb, MID_STACK.sch]
2018-01-28 Started work on Discrete Version
    [BUF.kicad_pcb]
2018-01-29 Working on JFET based amp, pots are an issue
    [BND.kicad_pcb, BND.sch]
2018-01-30 Schematics done, pcb layout pending:
    [BND.sch, BT.kicad_pcb, BT.sch, VOL.kicad_pcb, VOL.sch]
2018-01-30 Schematics done, pcb layout pending
2018-01-31 PCB Layout done
    [BT.dsn, BT.sch, VOL.dsn, VOL.sch]
2018-01-31 PCB Layout cleanup
    [BT.kicad_pcb, VOL.kicad_pcb]
2018-01-31 Changed Term Blocks in BT stack to JST connector to BND
    [BT.kicad_pcb, BT.sch]
2018-01-31 Flipped BT to VOL connector on BT board to bottom side for better conn
    [BT.kicad_pcb, BT.sch]
2018-01-31 Changed POT, parallel VOL pot conn for offboard pot
    [BT.kicad_pcb, BT.sch, VOL.kicad_pcb, VOL.sch]
2018-02-01 Some cleanup, and gain stage changes
    [BT.kicad_pcb, BT.sch, VOL.kicad_pcb, VOL.sch]
2018-02-01 Slight buffer change
    [VOL.kicad_pcb, VOL.sch]
2018-02-01 Pots were out by a little, changed PCBs accordingly
    [BT.kicad_pcb, VOL.kicad_pcb, VOL.sch, VOL_B.kicad_pcb, VOL_B.sch]
2018-02-03 Changed Gain structure a bit
    [BT.kicad_pcb, BT.sch, VOL.kicad_pcb, VOL.sch]
2018-02-04 Value and gain structure tweak
    [BT.kicad_pcb, BT.sch, VOL.kicad_pcb, VOL.sch]
2018-02-04 Sim Update - SF Load update
    [VOL.kicad_pcb, VOL.sch]
2018-02-05 Some Changes
    [BOM.xlsx, BT.kicad_pcb, BT.sch, BT_STACK.kicad_pcb, BUF.dsn, BUF.kicad_pcb, BUF.sch, MID_STACK.kicad_pcb]
2018-02-07 F0 Final
    [BOM.xlsx, BUF.dsn, BUF.kicad_pcb, BUF.sch, BUF_30x40.kicad_pcb, VOL.kicad_pcb, VOL.sch]
2018-02-08 Some fixes and refinement
    [BOM.xlsx, BUF.kicad_pcb, BUF.sch, VOL.kicad_pcb, VOL.sch]
2018-02-08 J Amp changed for imrpoved distortion performance
    [BOM.xlsx, BT.kicad_pcb, BT.sch]
2018-02-09 J BT Cap changes
    [BOM.xlsx, BT.kicad_pcb, BT.sch]
2018-02-09 J BT Caps to film
    [BOM.xlsx, BT.kicad_pcb, BT.sch]
2018-02-09 Various - BOM complete
    [BOM.xlsx, BT_STACK.kicad_pcb, BT_STACK.sch]
2018-02-11 Tone cap changed to female pin strip header for 0.047uF and 0.1uF
    [BOM.xlsx, BT.kicad_pcb, BT.sch, BT_STACK.kicad_pcb, BT_STACK.sch, VOL.kicad_pcb, VOL.sch]
2018-02-12 J BT Pot wired incorrectly
    [BT.kicad_pcb, BT.sch, VOL.sch]
2018-02-12 J Cap footprint changes
    [BOM.xlsx, BT.kicad_pcb]
2018-02-13 J BT Changes from SMD film caps to THT
    [BOM.xlsx, BT.kicad_pcb, BT.sch]
2018-02-14 J BT Track Changes
    [BT.kicad_pcb, BT.sch, VOL.kicad_pcb, VOL.sch]
2018-02-15 Cap change
    [BOM.xlsx]
2018-02-17 Mid Buff
    [BT_STACK.kicad_pcb, BT_STACK.sch, MID_STACK.kicad_pcb, MID_STACK.sch, VOL.kicad_pcb, VOL.sch]
2018-02-18 Change some caps to TH, updated BOM - need to recreate
    [BOM.xlsx, BT_STACK.kicad_pcb, BT_STACK.sch, MID_STACK.kicad_pcb, MID_STACK.sch]
2018-02-18 Some extras
    [BOM.xlsx, BT_STACK.kicad_pcb, BT_STACK.sch]
2018-02-19 Tone pot 20k
    [VOL.kicad_pcb, VOL.sch]
2018-02-19 J BT ... not much
    [BT.kicad_pcb]
2018-02-28 Add JFET Vgs(off) test board)
    [TST.kicad_pcb, TST.sch]
2018-02-28 Old Gerbers removed
    [A_BND_BUF-B.Cu.gbl, A_BND_BUF-B.Mask.gbs, A_BND_BUF-B.SilkS.gbo, A_BND_BUF-Edge.Cuts.gko, A_BND_BUF-F.Cu.gtl, A_BND_BUF-F.Mask.gts, A_BND_BUF-F.SilkS.gto, A_BND_BUF.drl]
2018-02-28 Mods and gerbers done
    [A_BND_BUF-B.Cu.gbl, A_BND_BUF-B.Mask.gbs, A_BND_BUF-B.SilkS.gbo, A_BND_BUF-Edge.Cuts.gko, A_BND_BUF-F.Cu.gtl, A_BND_BUF-F.Mask.gts, A_BND_BUF-F.SilkS.gto, A_BND_BUF.drl]
2018-03-01 Changed some layout for pot overlap
    [VOL-B.Cu.gbl, VOL-B.Mask.gbs, VOL-B.Paste.gbp, VOL-B.SilkS.gbo, VOL-F.Cu.gtl, VOL-F.Mask.gts, VOL-F.Paste.gtp, VOL-F.SilkS.gto]
2018-03-03 convert drl to txt files
    [combined.drl, combined.gbl, combined.gbo, combined.gbp, combined.gbs, combined.gko, combined.gm1, combined.gtl]
2018-04-11 F1 updates to reverse pots
    [BUF.kicad_pcb, BUF.sch, HPF.kicad_pcb, HPF.sch, VOL.kicad_pcb, VOL.sch]
2018-04-13 HPF Done
    [HPF.kicad_pcb, VOL.kicad_pcb, VOL.sch]
2018-04-25 J0 Tone Pot Fixup
    [VOL.kicad_pcb, VOL.sch]
2018-04-25 J0 Tone Control Fixup
    [VOL.kicad_pcb, VOL.sch]
2018-04-26 Revert some changes
    [VOL.kicad_pcb, VOL.sch]
2018-04-26 Final J0 tone pot fixes
    [VOL.kicad_pcb, VOL.sch]
2018-04-26 J0 VOL board modded for all CONN on bottom side
    [VOL.kicad_pcb, VOL.sch]
2018-04-26 J0 VOL removed VOL CONN, slight rerouting
    [VOL.kicad_pcb, VOL.sch]
2018-04-27 Normalising Schematics part list for J0
    [BT.kicad_pcb, BT.sch, VOL.kicad_pcb, VOL.sch]
2018-04-29 J0 prepped for board run with blend board
    [BND.kicad_pcb, BND.sch, BT.kicad_pcb, BT.sch, VOL.kicad_pcb, VOL_B.kicad_pcb, VOL_B.sch]
2018-04-29 J0 - Panelisation
    [BND-B.Cu.gbl, BND-B.Mask.gbs, BND-B.Paste.gbp, BND-B.SilkS.gbo, BND-Edge.Cuts.gko, BND-F.Cu.gtl, BND-F.Mask.gts, BND-F.Paste.gtp]
2018-04-30 BOM complete and changes made to PCBs for cap changes
    [BOM.xlsx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]
2018-04-30 Part no updates
    [BOM.xlsx]
2018-04-30 Gerbers fixed - ready to go
    [BND-B.Cu.gbl, BND-B.Mask.gbs, BND-B.Paste.gbp, BND-B.SilkS.gbo, BND-Edge.Cuts.gm1, BND-F.Cu.gtl, BND-F.Mask.gts, BND-F.Paste.gtp]
2018-04-30 Ready to go
    Reverted J0_BND to include P/U inputs
    [BND-B.Cu.gbl, BND-B.Mask.gbs, BND-B.Paste.gbp, BND-B.SilkS.gbo, BND-Edge.Cuts.gm1, BND-F.Cu.gtl, BND-F.Mask.gts, BND-F.Paste.gtp]
2018-05-03 F0 Mid Stack fixed
    [MID_STACK.kicad_pcb, MID_STACK.sch]
2018-05-03 BOM Update
    [BOM.xlsx]
2018-05-03 F0 BT stack changed slightly
    [BT_STACK.kicad_pcb, BT_STACK.sch]
2018-05-05 F0 Pot Wiring reversed after testing
    [MID_STACK.kicad_pcb, MID_STACK.sch]
2018-05-09 Refined Buffer F0
    [BUF.dsn, BUF.kicad_pcb, BUF.sch]
2018-05-09 F0 Conn changes
    [BT_STACK.kicad_pcb, BT_STACK.sch, BUF.sch, MID_STACK.kicad_pcb]
2018-05-09 F0 - Boost only bass
    [BT_STACK.dsn, BT_STACK.kicad_pcb, BT_STACK.sch]
2018-05-10 F0 - Boost only - boost/cut bypass
    [BT_STACK.kicad_pcb, BT_STACK.sch]
2018-05-10 Slight changes
    [BT_STACK.kicad_pcb, BUF.kicad_pcb]
2018-05-10 BOM - Some caps cheaper at RS
    [BOM.xlsx]
2018-05-10 F0 BT Layout
    [BT_STACK.kicad_pcb, BT_STACK.sch]
2018-05-11 Some changes to names
    [BOM.xlsx, BT_STACK.dsn, BT_STACK.kicad_pcb, BT_STACK.sch, BUF.dsn, BUF.kicad_pcb, BUF.sch]
2018-05-11 F0 - Fixed Mid Stack, BT, BUF
    [BUF.kicad_pcb, MID_STACK.kicad_pcb, MID_STACK.sch]
2018-05-11 F0 BUF changed rotation
    [BUF.kicad_pcb, BUF.sch]
2018-05-11 Tone Pot connector and output routing added
    [BUF.kicad_pcb, BUF.sch]
2018-05-12 F0 Vol/Vol spec LOG pots
    [BUF.kicad_pcb, BUF.sch]
2018-05-13 F0 - BUF JFET bypass caps at i/p
    [BUF.kicad_pcb, BUF.sch]
2018-05-15 Single Board J0 - J1
    [J1.kicad_pcb, J1.sch]
2018-05-18 Adding MM
    [J1.kicad_pcb, J1.sch, MID_STACK.dsn, MID_STACK.kicad_pcb, MID_STACK.sch]
2018-05-20 Adding Datasheets
    [BT.kicad_pcb, BT.sch]
2018-05-22 Updates MM
    [BT.sch, MID_STACK.sch]
2018-05-22 MM Update
    [BT.sch]
2018-05-23 PCB Started
    [BT.kicad_pcb, BT.sch]
2018-05-24 MM Finished board layouts
    [BND.kicad_pcb, BND.sch, BT.kicad_pcb, BT.sch, MID_STACK.kicad_pcb, MID_STACK.sch, MMPU_SWITCH.xlsx]
2018-05-24 MM T ctrl reversed for proper operation
    [BT.kicad_pcb, BT.sch]
2018-05-24 Switch schematics
    [SW.kicad_pcb, SW.sch]
2018-05-25 MM Routing complete
    [BND.kicad_pcb, BND.sch, BT.kicad_pcb, BT.sch, SW.kicad_pcb, SW.sch, SW_MM.kicad_pcb, SW_MM.sch]
2018-05-25 MM Tweaks
    [BND.kicad_pcb, BT.kicad_pcb, MID_STACK.kicad_pcb, SW_MM.kicad_pcb, SW_SEL.kicad_pcb]
2018-05-25 MM BT Tweak for weak gnd and vref to IC1
    [BT.kicad_pcb, BT.sch]
2018-05-26 MM - Board changes
    [BASS.kicad_pcb, BASS.sch, BT.sch, MID_STACK.kicad_pcb, MID_STACK.sch]
2018-06-02 MM Connector Verification
    [BND.kicad_pcb, BND.sch, BT.sch]
2018-06-02 Board Labels
    [BASS.kicad_pcb, BASS.sch, BND.kicad_pcb, BT.kicad_pcb]
2018-06-04 MM Switches and BOM
    [BOM.xlsx, BT.sch, SW_BR.kicad_pcb, SW_BR.sch, SW_MM.kicad_pcb, SW_SEL.kicad_pcb]
2018-06-04 MM Gerbers, BASS pot fixup
    [BASS-B.Cu.gbl, BASS-B.Mask.gbs, BASS-B.Paste.gbp, BASS-B.SilkS.gbo, BASS-Edge.Cuts.gko, BASS-F.Cu.gtl, BASS-F.Mask.gts, BASS-F.Paste.gtp]
2018-06-05 MM Gerbers Finished, Mid Stack Ammended J0
    [BND-B.Cu.gbl, BND-B.Mask.gbs, BND-B.Paste.gbp, BND-B.SilkS.gbo, BND-Edge.Cuts.gm1, BND-F.Cu.gtl, BND-F.Mask.gts, BND-F.Paste.gtp]
2018-06-05 F0 Gerbers
    [BT_STACK-B.Cu.gbl, BT_STACK-B.Mask.gbs, BT_STACK-B.Paste.gbp, BT_STACK-B.SilkS.gbo, BT_STACK-Edge.Cuts.gko, BT_STACK-F.Cu.gtl, BT_STACK-F.Mask.gts, BT_STACK-F.Paste.gtp]
2018-06-05 MM Gerber update
    [MID_STACK-B.Cu.gbl, MID_STACK-B.Mask.gbs, MID_STACK-B.Paste.gbp, MID_STACK-B.SilkS.gbo, MID_STACK-Edge.Cuts.gko, MID_STACK-F.Cu.gtl, MID_STACK-F.Mask.gts, MID_STACK-F.Paste.gtp]
2018-06-05 MM Switch Config Changed
    [BASS-B.Cu.gbl, BASS-B.Mask.gbs, BASS-B.Paste.gbp, BASS-B.SilkS.gbo, BASS-Edge.Cuts.gko, BASS-F.Cu.gtl, BASS-F.Mask.gts, BASS-F.Paste.gtp]
2018-06-05 MM Gerbers
    [combined.gbl, combined.gbo, combined.gbp, combined.gbs, combined.gko, combined.gm1, combined.gtl, combined.gto]
2018-06-06 BT Bright Cap/Res changed
    [BT-B.Cu.gbl, BT-B.Mask.gbs, BT-B.Paste.gbp, BT-B.SilkS.gbo, BT-Edge.Cuts.gko, BT-F.Cu.gtl, BT-F.Mask.gts, BT-F.Paste.gtp]
2018-06-07 MM Switch
    [BOM.xlsx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]
2018-06-08 MM Refactoring
    [BND.kicad_pcb, BND.sch, BOM.xlsx, BT.kicad_pcb, BT.sch, MID_STACK.kicad_pcb, MID_STACK.sch, SW_BR.kicad_pcb]
2018-06-12 F0 Tone CTRL
    [VOL.kicad_pcb, VOL.sch]
2018-06-13 Minor tweaks for MM/F0 - gerbers ready to go out
    [BASS-B.Cu.gbl, BASS-B.Mask.gbs, BASS-B.Paste.gbp, BASS-B.SilkS.gbo, BASS-Edge.Cuts.gko, BASS-F.Cu.gtl, BASS-F.Mask.gts, BASS-F.Paste.gtp]
2018-06-13 MM PCB comments
    [SW_BR-B.Cu.gbl, SW_BR-B.Mask.gbs, SW_BR-B.Paste.gbp, SW_BR-B.SilkS.gbo, SW_BR-Edge.Cuts.gko, SW_BR-F.Cu.gtl, SW_BR-F.Mask.gts, SW_BR-F.Paste.gtp]
2018-06-13 BOM Work prior to sending Gerbers
    [BOM.xlsx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]
2018-06-13 BOM Updates
    [BOM.xlsx, BT_STACK.kicad_pcb, BT_STACK.sch]
2018-06-14 BOM Work complete
    [BOM.xlsx]
2018-06-14 F0 Gerbers redone after BOM changes
    [BT_STACK-B.Cu.gbl, BT_STACK-B.Mask.gbs, BT_STACK-B.Paste.gbp, BT_STACK-B.SilkS.gbo, BT_STACK-Edge.Cuts.gko, BT_STACK-F.Cu.gtl, BT_STACK-F.Mask.gts, BT_STACK-F.Paste.gtp]
2018-06-14 Minor BOM changes
    [BOM.xlsx, BT.kicad_pcb, BT.sch]
2018-06-14 Gerbers altered and sent
    [BASS-B.Cu.gbl, BASS-B.Mask.gbs, BASS-B.Paste.gbp, BASS-B.SilkS.gbo, BASS-Edge.Cuts.gko, BASS-F.Cu.gtl, BASS-F.Mask.gts, BASS-F.Paste.gtp]
2018-06-14 Remove Basket from BOM
    [BOM.xlsx]
2018-08-26 J0 - BT Connectors changed to pin headers
    [BT-2018-08-27-08-16-16.sch, BT.kicad_pcb, BT.sch]
2018-08-27 J0 - Modified all files to remove JST connectors
    [BND-B.Cu.gbl, BND-B.Mask.gbs, BND-B.Paste.gbp, BND-B.SilkS.gbo, BND-Edge.Cuts.gko, BND-Edge.Cuts.gm1, BND-F.Cu.gtl, BND-F.Mask.gts]
2018-08-27 J0 - Changed BT Caps to larger/Cheaper form factor
    [BT-B.Cu.gbl, BT-B.Mask.gbs, BT-B.Paste.gbp, BT-B.SilkS.gbo, BT-Edge.Cuts.gko, BT-F.Cu.gtl, BT-F.Mask.gts, BT-F.Paste.gtp]
2018-08-28 J0 - Gerbers changed
    [BT-B.Cu.gbl, BT-B.Mask.gbs, BT-B.Paste.gbp, BT-B.SilkS.gbo, BT-Edge.Cuts.gko, BT-F.Cu.gtl, BT-F.Mask.gts, BT-F.Paste.gtp]
2018-08-28 J0 - BND
    [BND-B.Cu.gbl, BND-B.Mask.gbs, BND-B.Paste.gbp, BND-B.SilkS.gbo, BND-F.Cu.gtl, BND-F.Mask.gts, BND-F.Paste.gtp, BND-F.SilkS.gto]
2018-08-28 J0 BT C to SMT
    [BT-B.Cu.gbl, BT-B.Mask.gbs, BT-B.Paste.gbp, BT-B.SilkS.gbo, BT-Edge.Cuts.gko, BT-F.Cu.gtl, BT-F.Mask.gts, BT-F.Paste.gtp]
